fcc89/ovctrl/pcb/Pics and plots/IMG_5339.jpg

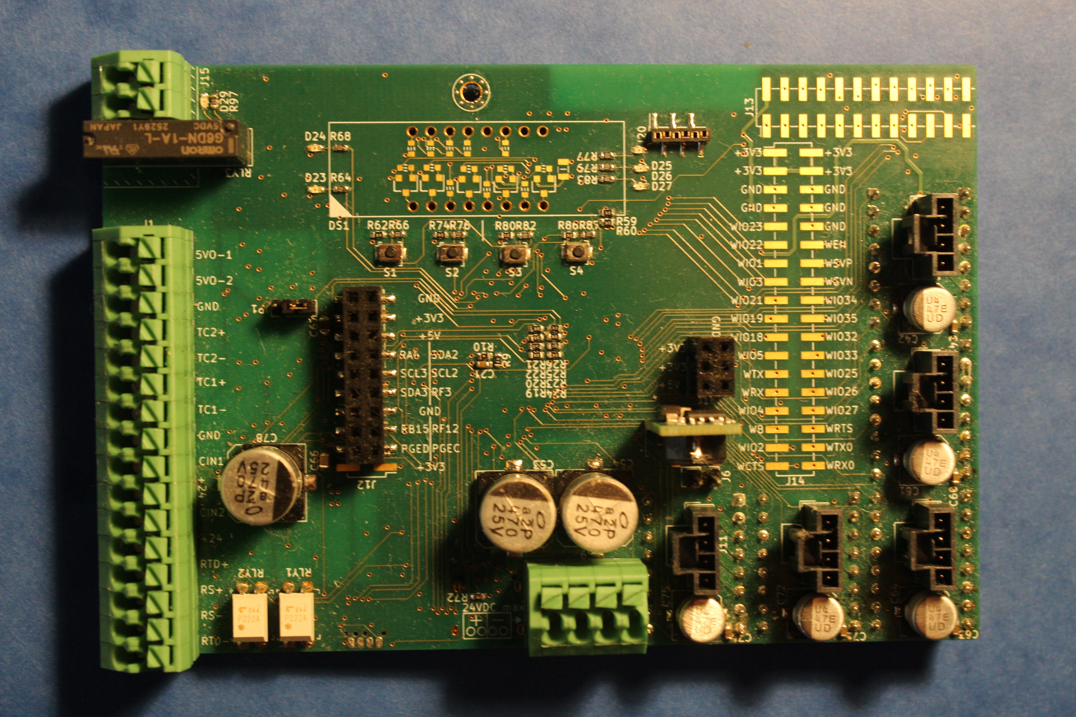
pcb/Pics and plots/IMG_5339.jpg
