fcc89/ovctrl/pcb/Pics and plots/B-bottomView.png

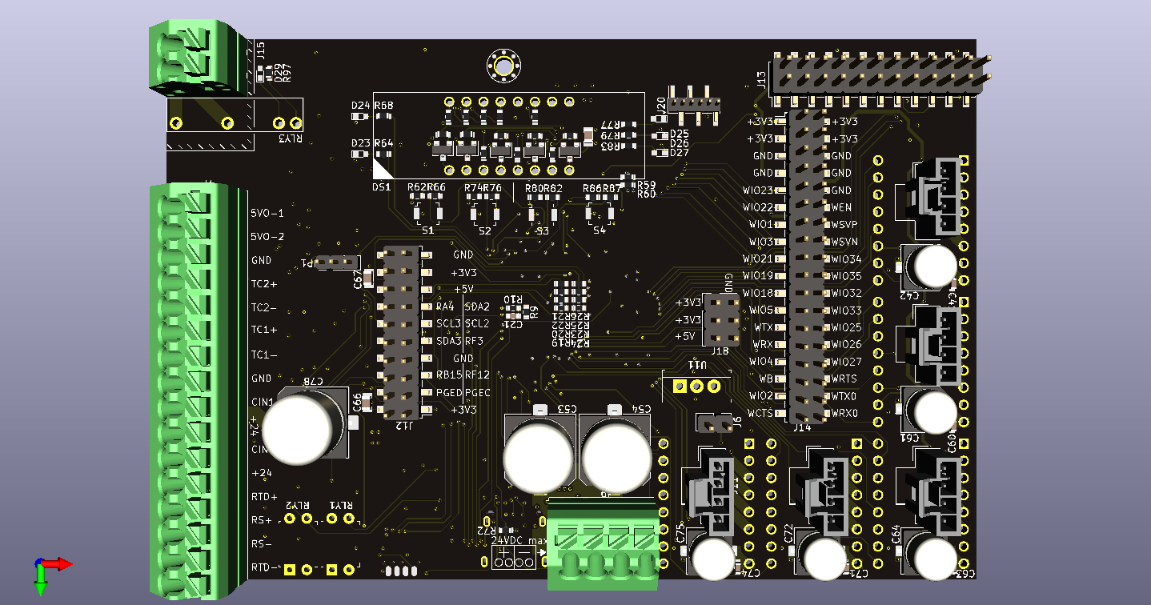
pcb/Pics and plots/B-bottomView.png
