fcc89/ovctrl/README.md

# ROVEN
Testboard for a reflow oven controller
