fcc89/ovctrl/pcb/Pics and plots/C-topView.png

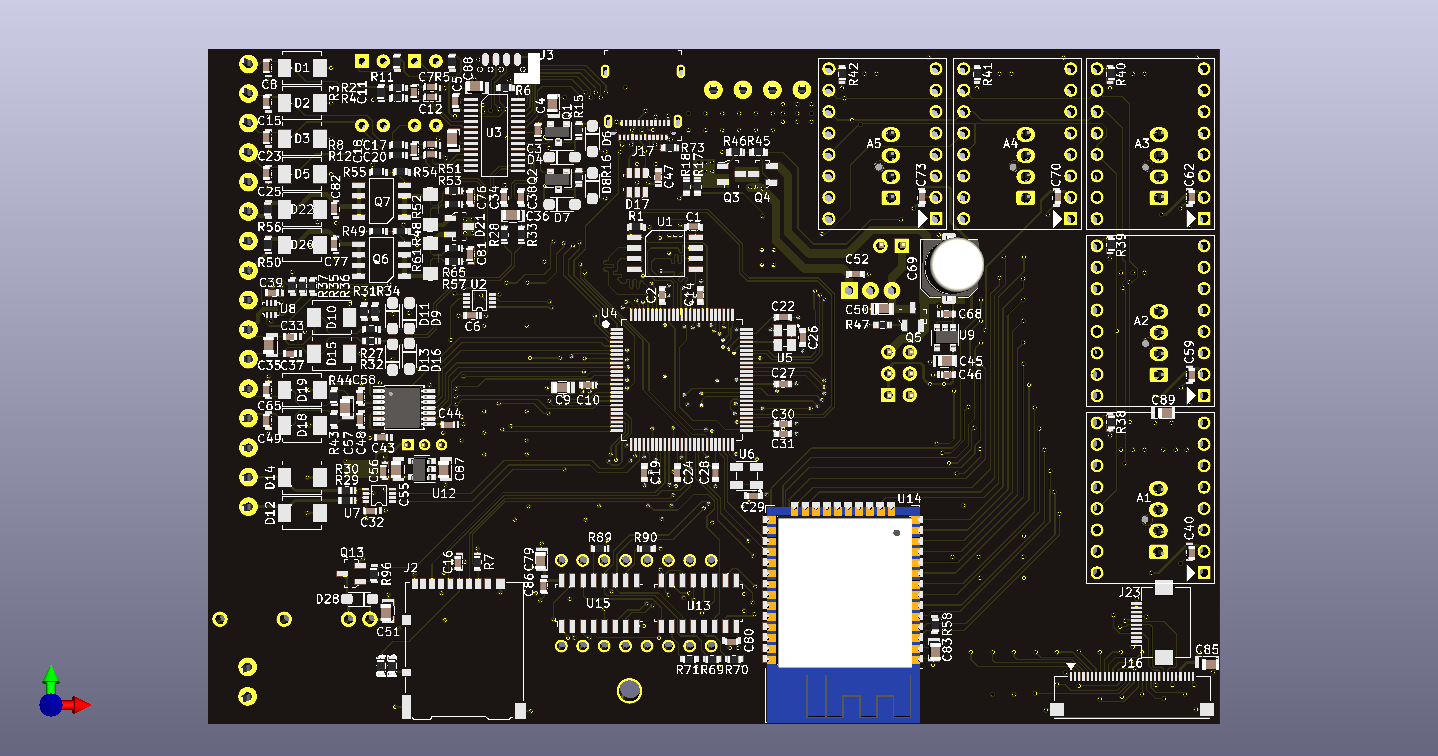
pcb/Pics and plots/C-topView.png
