fcc89/ovctrl/pcb/Pics and plots/IMG_5340.jpg

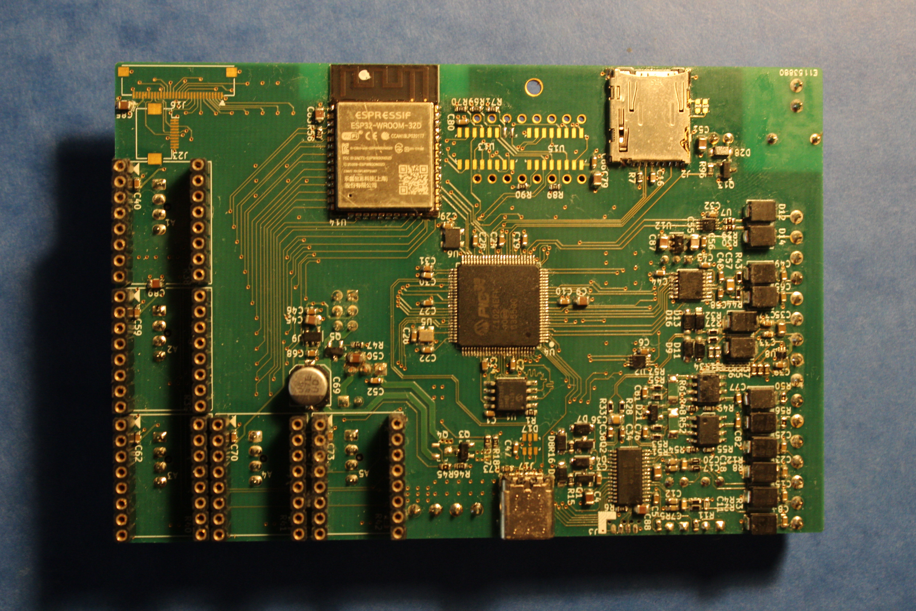
pcb/Pics and plots/IMG_5340.jpg
