fcc89/ovctrl/pcb/Pics and plots/A-Schematic.pdf

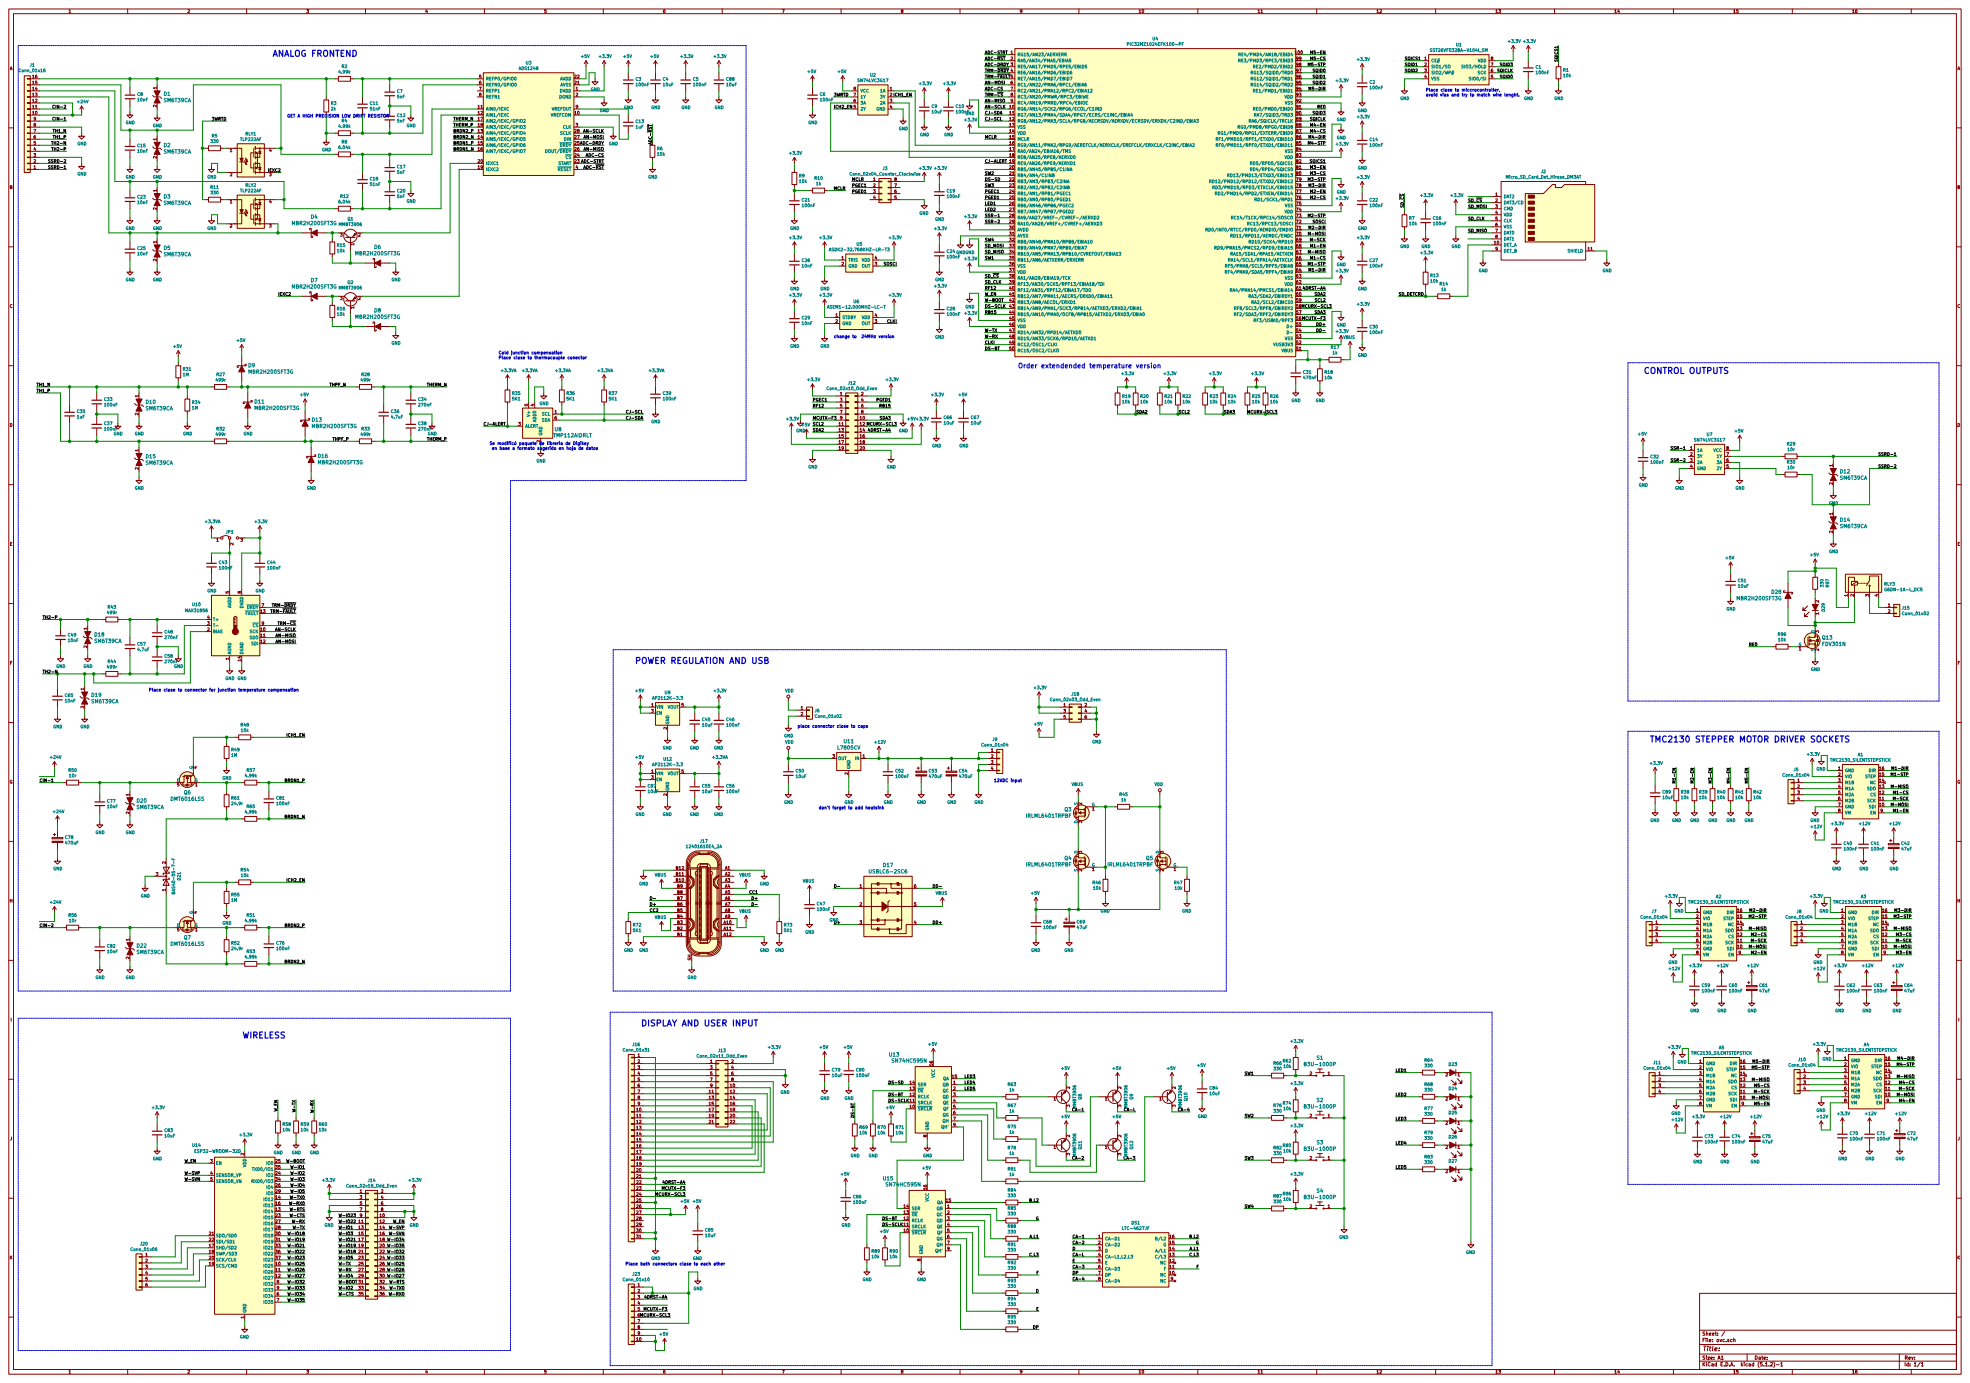
[picture p5: page 1]

ADC-STRT ADC-RST ADC-DRDY

SQICS1 Place close to miccrocontroller, avoid vias and try to match wire lenght.

TRM-DRDY
TRM-FAULT
AN-MOSI AN-MISO
ADC-CS
TRM-CS

AN-SCLK
CJ-SCL CJ-SDA

ADC-DRDY

ADC-STRT ADC-RST GND

Cold junction compensation
Place close to thermocouple conector GND

CJ-SCL CJ-SDA CJ-ALERT

Se modificó paquete de libreria de Digikey
en base a formato sugerido en hoja de datos

1 SCK 10 SDO 11 SDI 12 FAULT 13 DGND 14 BIAS 2 T- 3 T+ 4 AVDD

POWER REGULATION AND USB

Place close to connector for junction temperature compensation
10k GND

place connector close to caps

TMC2130 STEPPER MOTOR DRIVER SOCKETS

don't forget to add heatsink

BRDN2_N
+3.3V W-TX0 W-RX0 W-RTS W-CTS W-BOOT W-RX W-TX

DISPLAY AND USER INPUT
J16 Conn_01x31 GND

10uF GND
DS-SCLK DS-BT DS-BT DS-SCLK
10k GNDDS-BT

2 SCK/CLK 20 SDO/SD0 21 SDI/SD1 22

Place both connectors close to each other

Id: 1/1 Title: File: ovc.sch Sheet: /
