fcc89/ovctrl/pcb/Pics and plots/ovc-B_SilkS.pdf

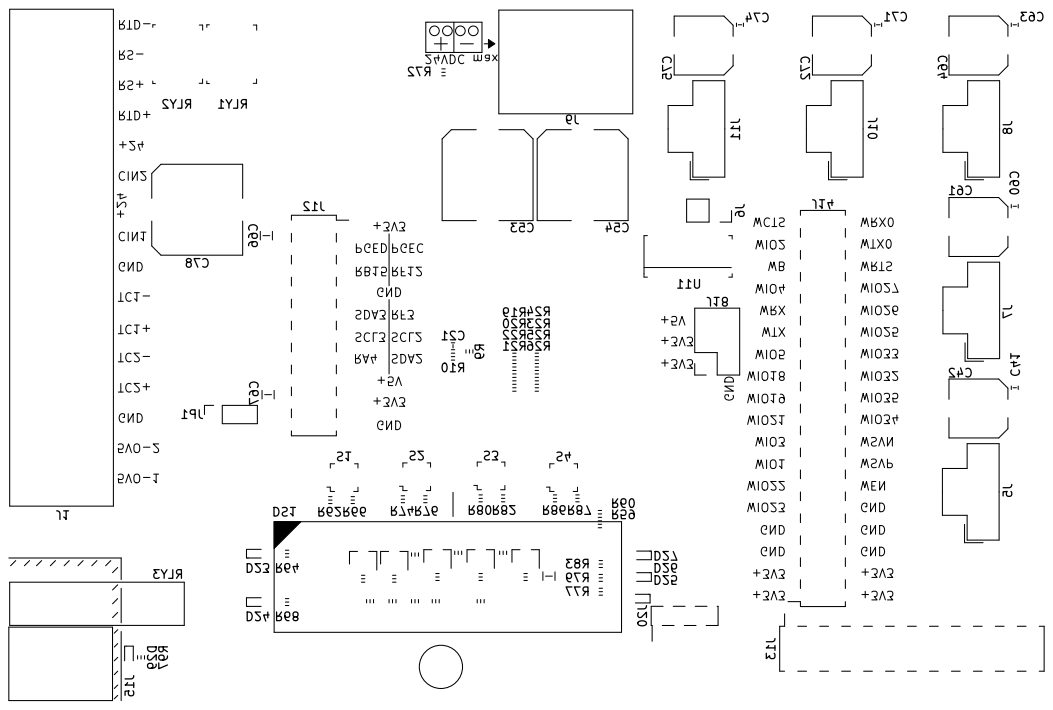
[picture p6: page 1]

WRX0 WTX0 WRTS WIO27 WIO26 WIO25 WIO33 WIO32 WIO35 WIO34 WSVN WSVP WEN GND GND GND
