fcc89/ovctrl/pcb/schematic.pdf

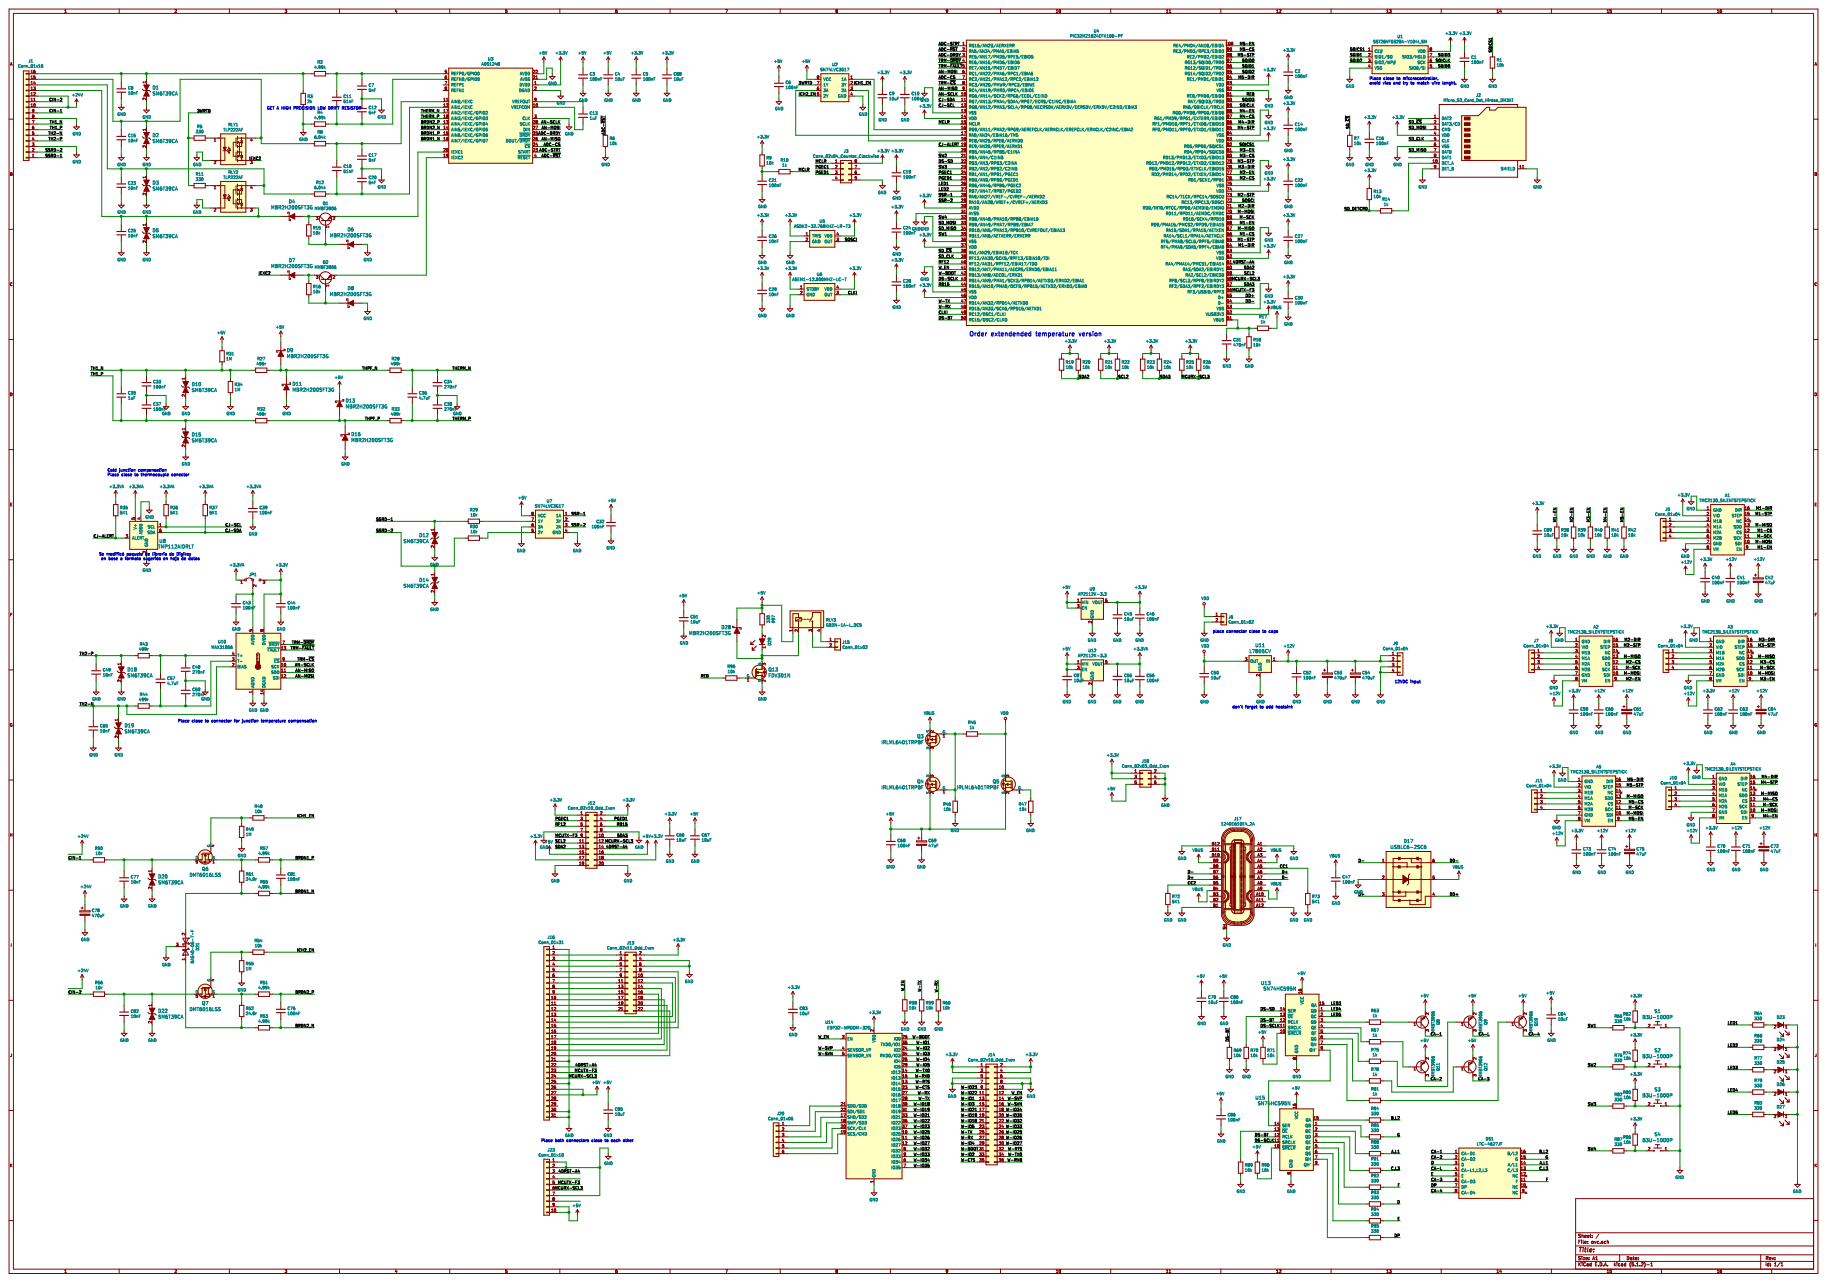
[picture p7: page 1]
