fcc89/ovctrl/pcb/bfab.pdf

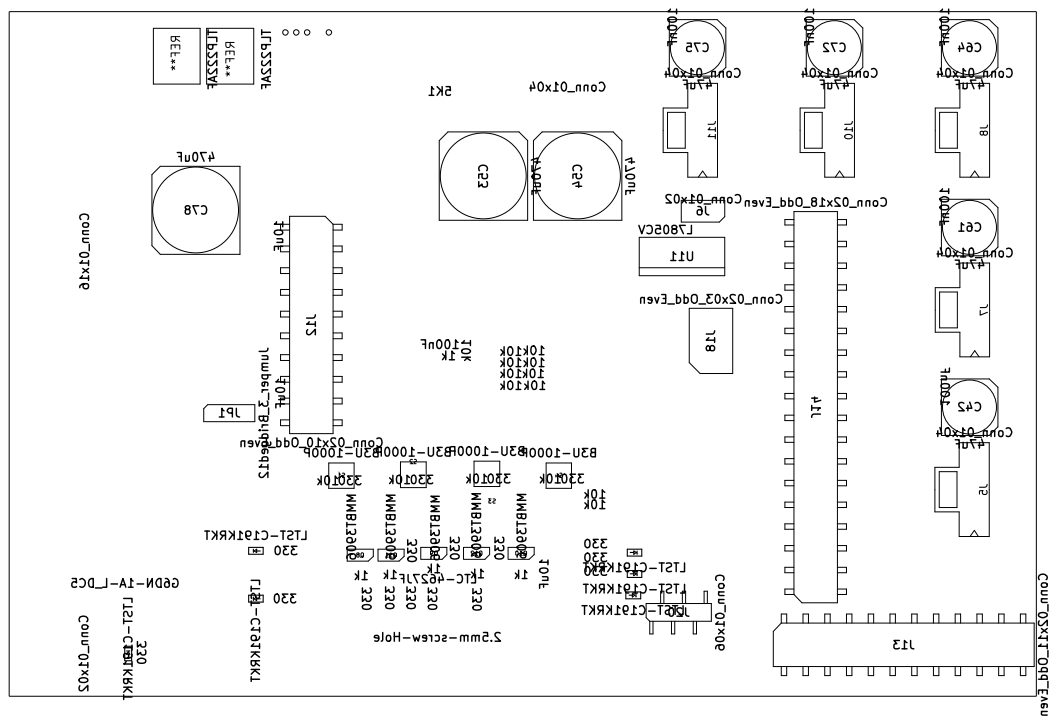
[picture p8: page 1]
