fcc89/ovctrl/pcb/ffab.pdf

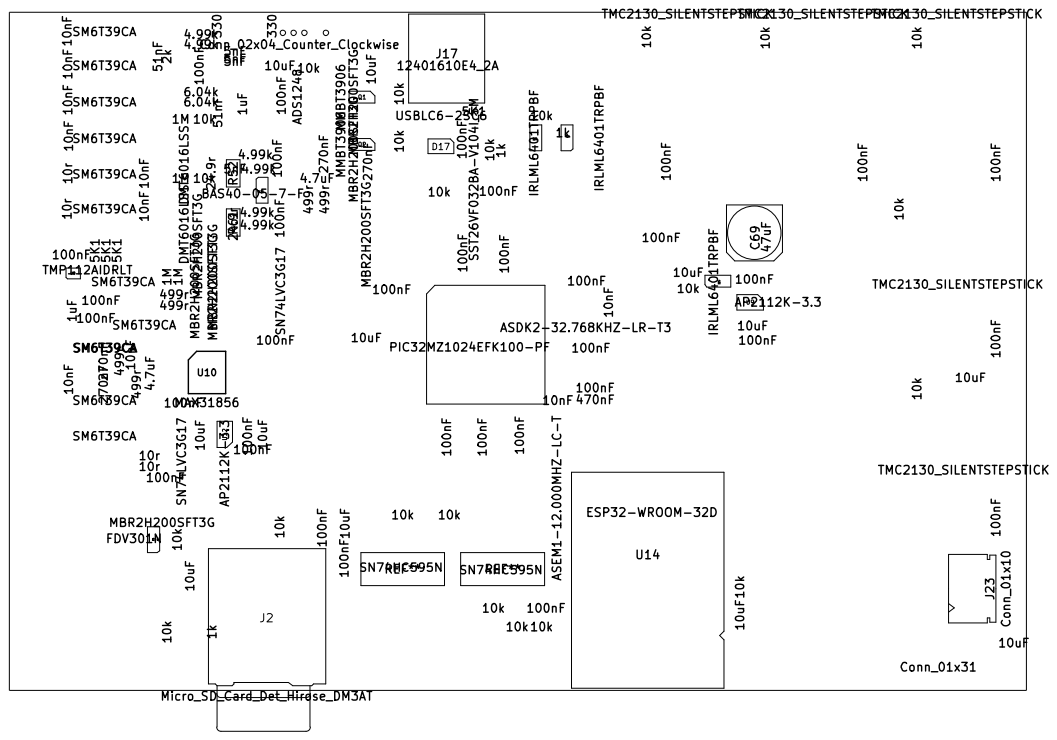
[picture p9: page 1]
