fcc89/ovctrl/pcb/Pics and plots/ovc-B_Cu.pdf

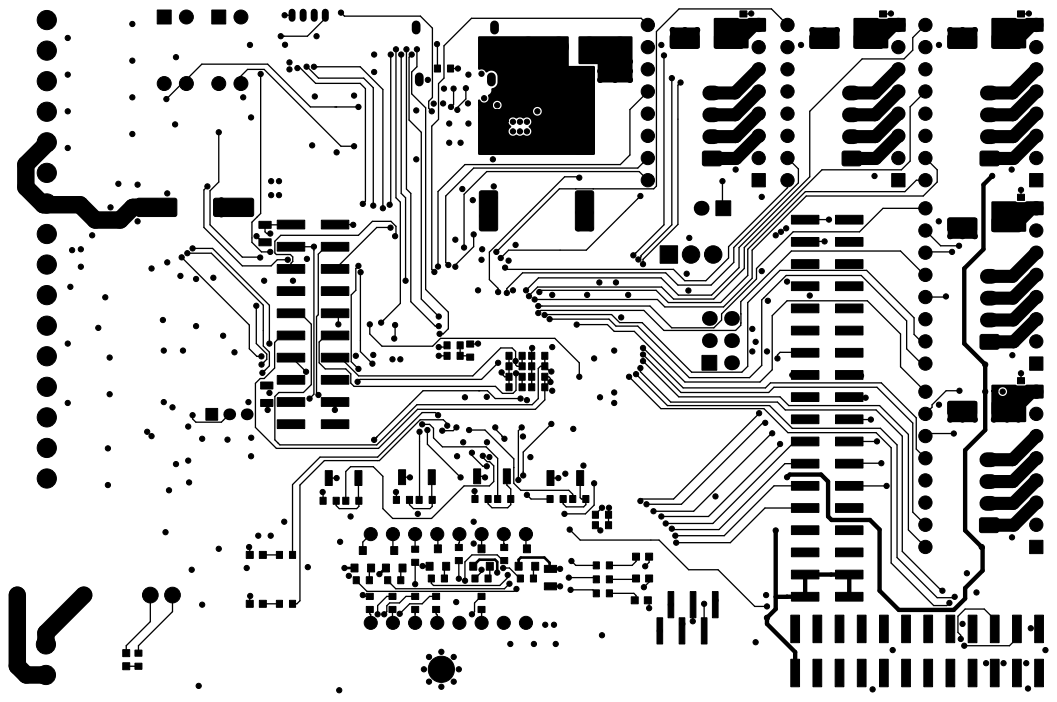
[picture p10: page 1]
