fcc89/ovctrl/pcb/Pics and plots/ovc-B_Mask.pdf

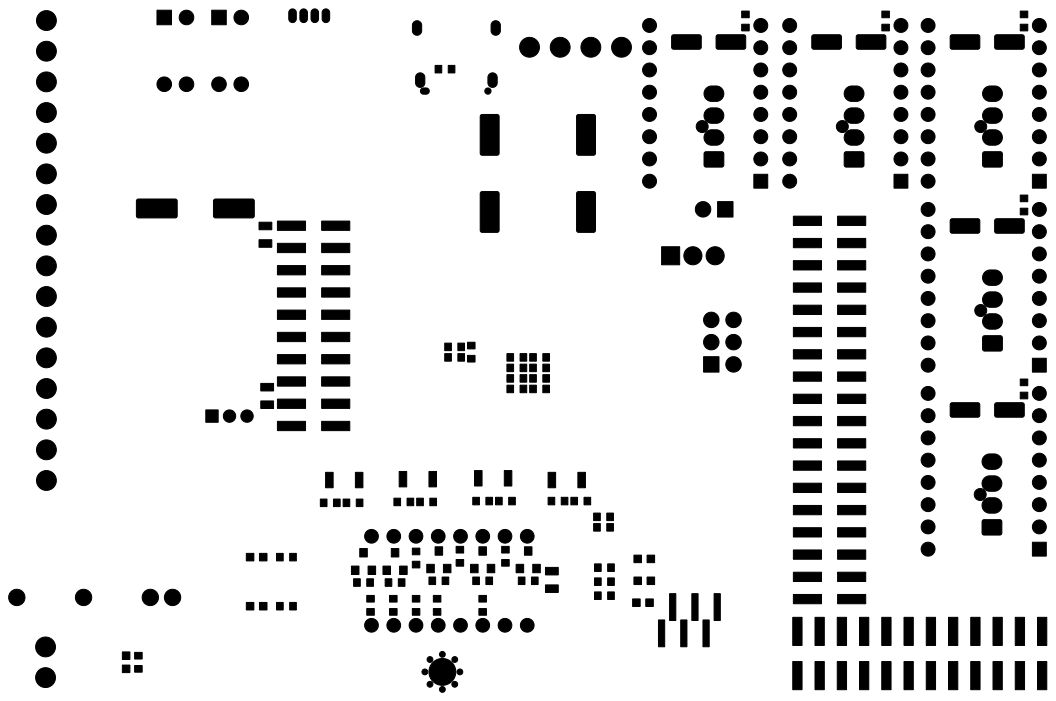
[picture p11: page 1]
