fcc89/ovctrl/pcb/Pics and plots/ovc-Edge_Cuts.pdf

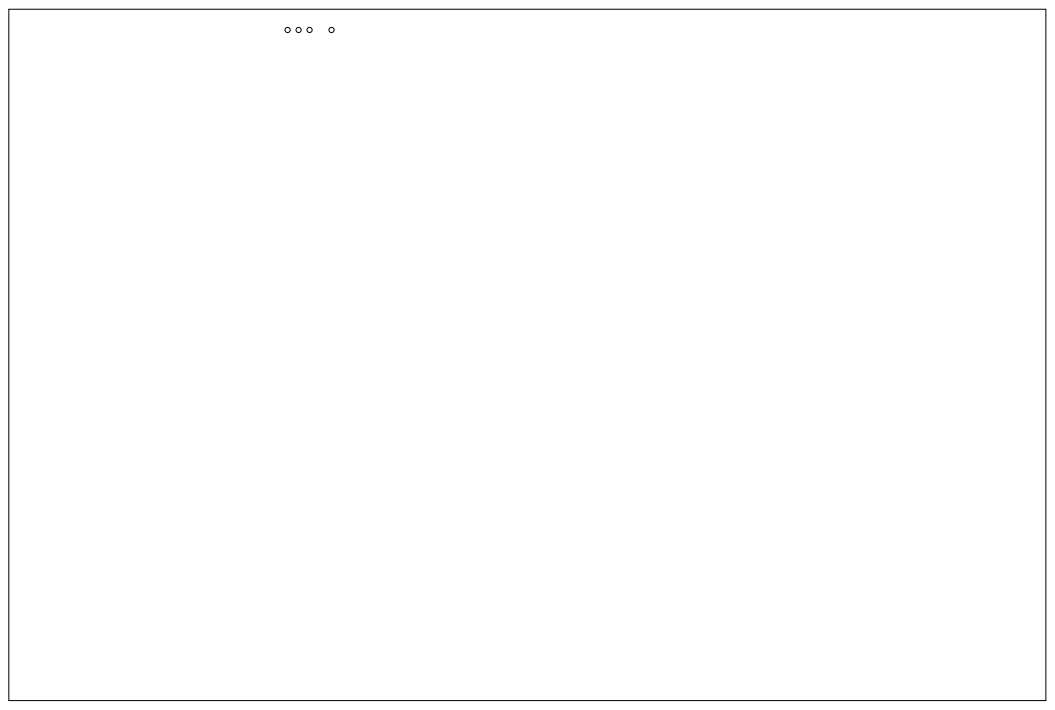
[picture p12: page 1]
