fcc89/ovctrl/pcb/Pics and plots/ovc-F_Cu.pdf

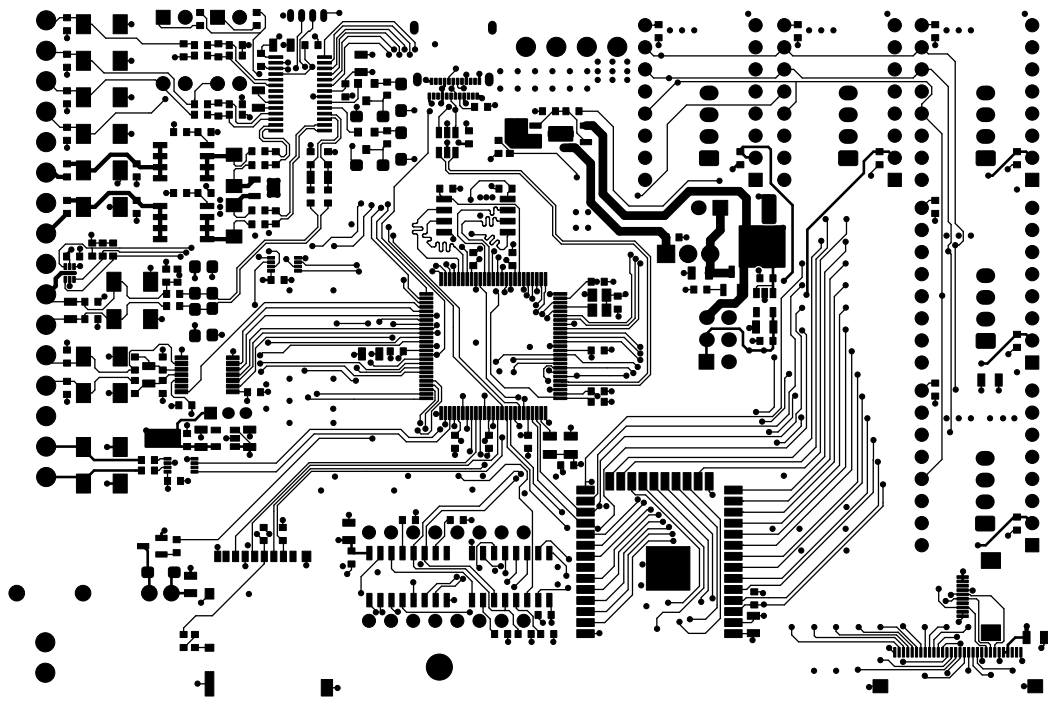
[picture p13: page 1]
