fcc89/ovctrl/pcb/Pics and plots/ovc-F_Mask.pdf

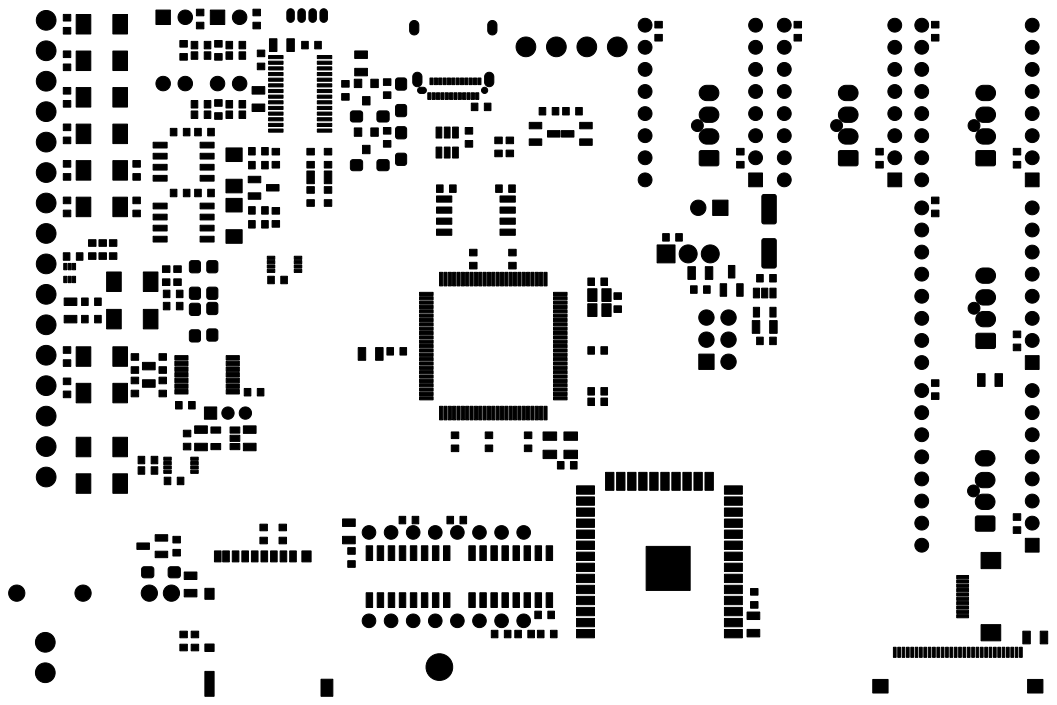
[picture p14: page 1]
