fcc89/ovctrl/pcb/Pics and plots/ovc-F_SilkS.pdf

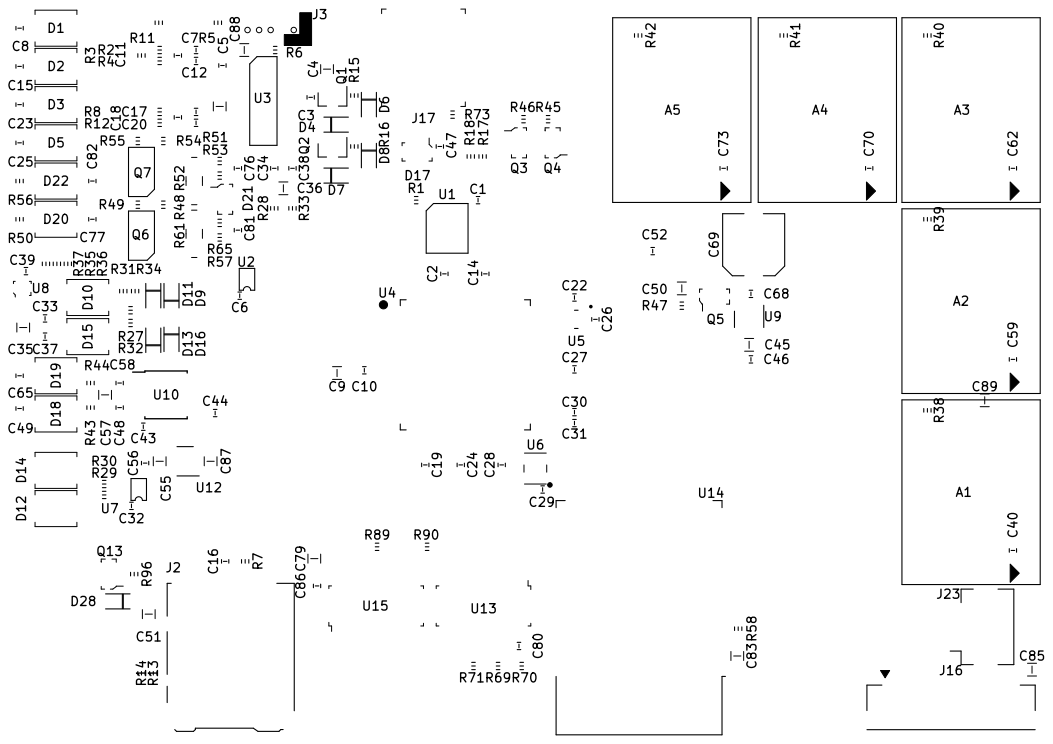
[picture p15: page 1]
