fcc89/ovctrl/pcb/Pics and plots/ovc-In1_Cu.pdf

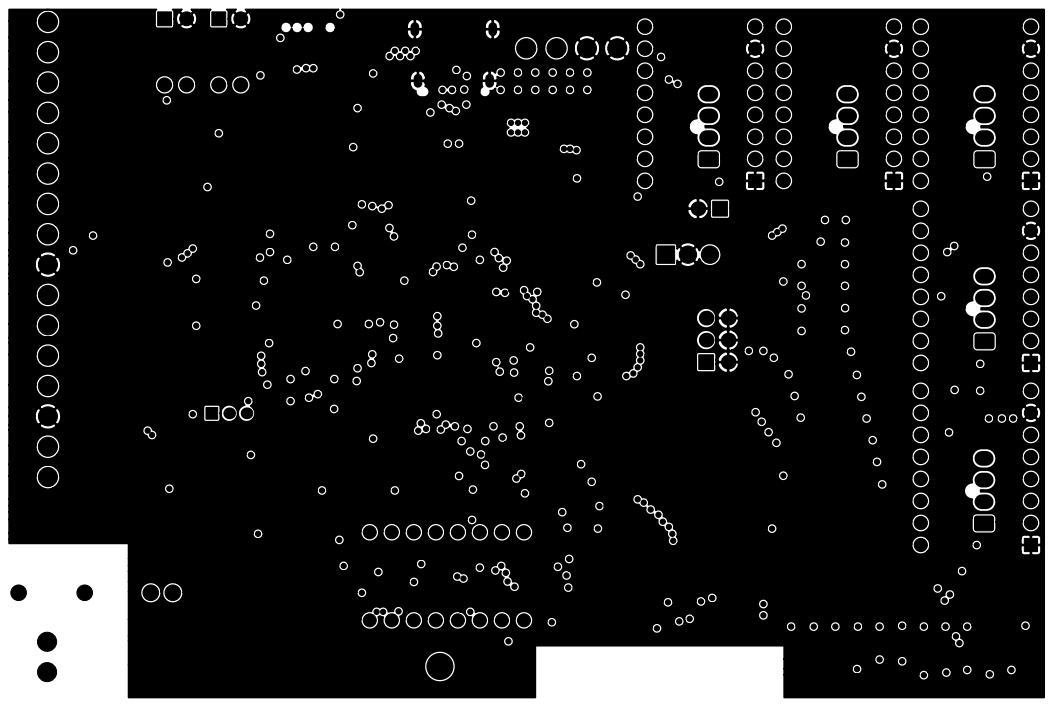
[picture p16: page 1]
