fcc89/ovctrl/pcb/Pics and plots/ovc-In2_Cu.pdf

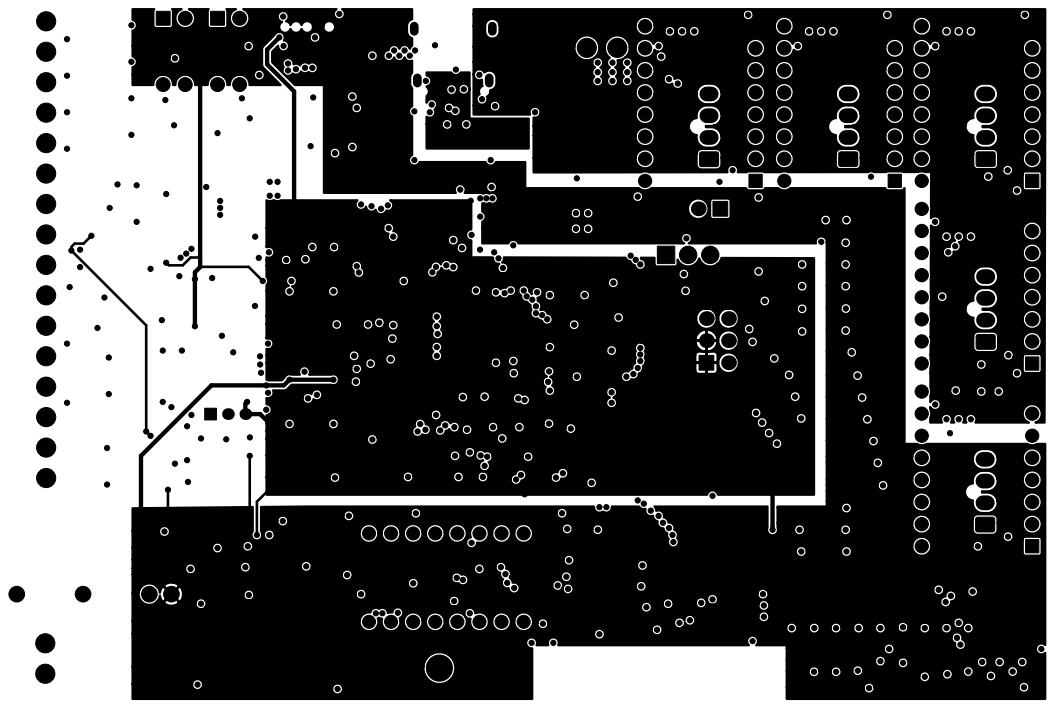
[picture p17: page 1]
