fcc89/ovctrl/pcb/ovc.kicad_pcb

## KiCad design pcb/ovc.kicad_pcb (2019-11-24)

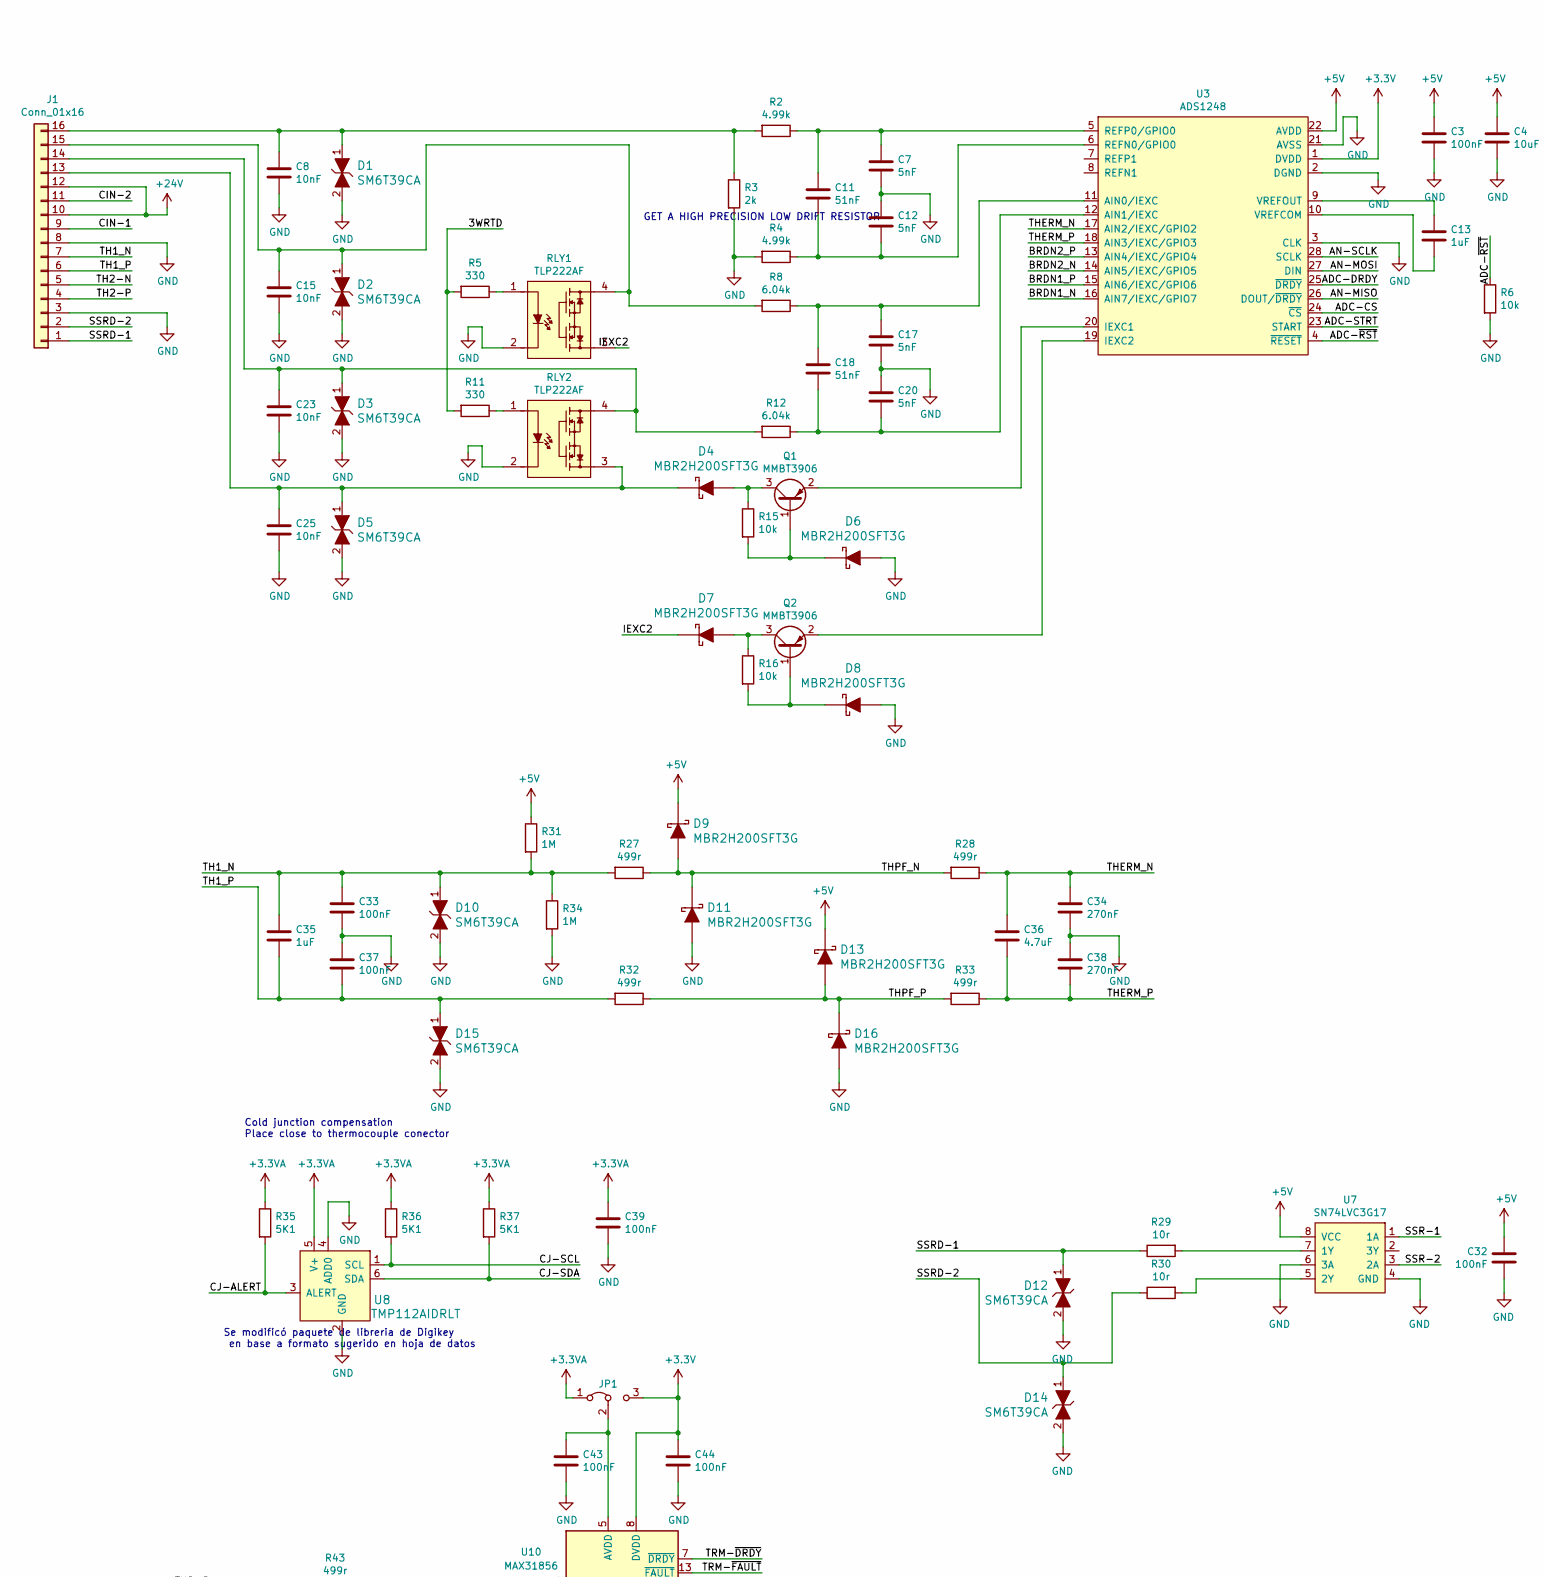
[picture p18: schematic ovc.sch, part in row 1, column 1]

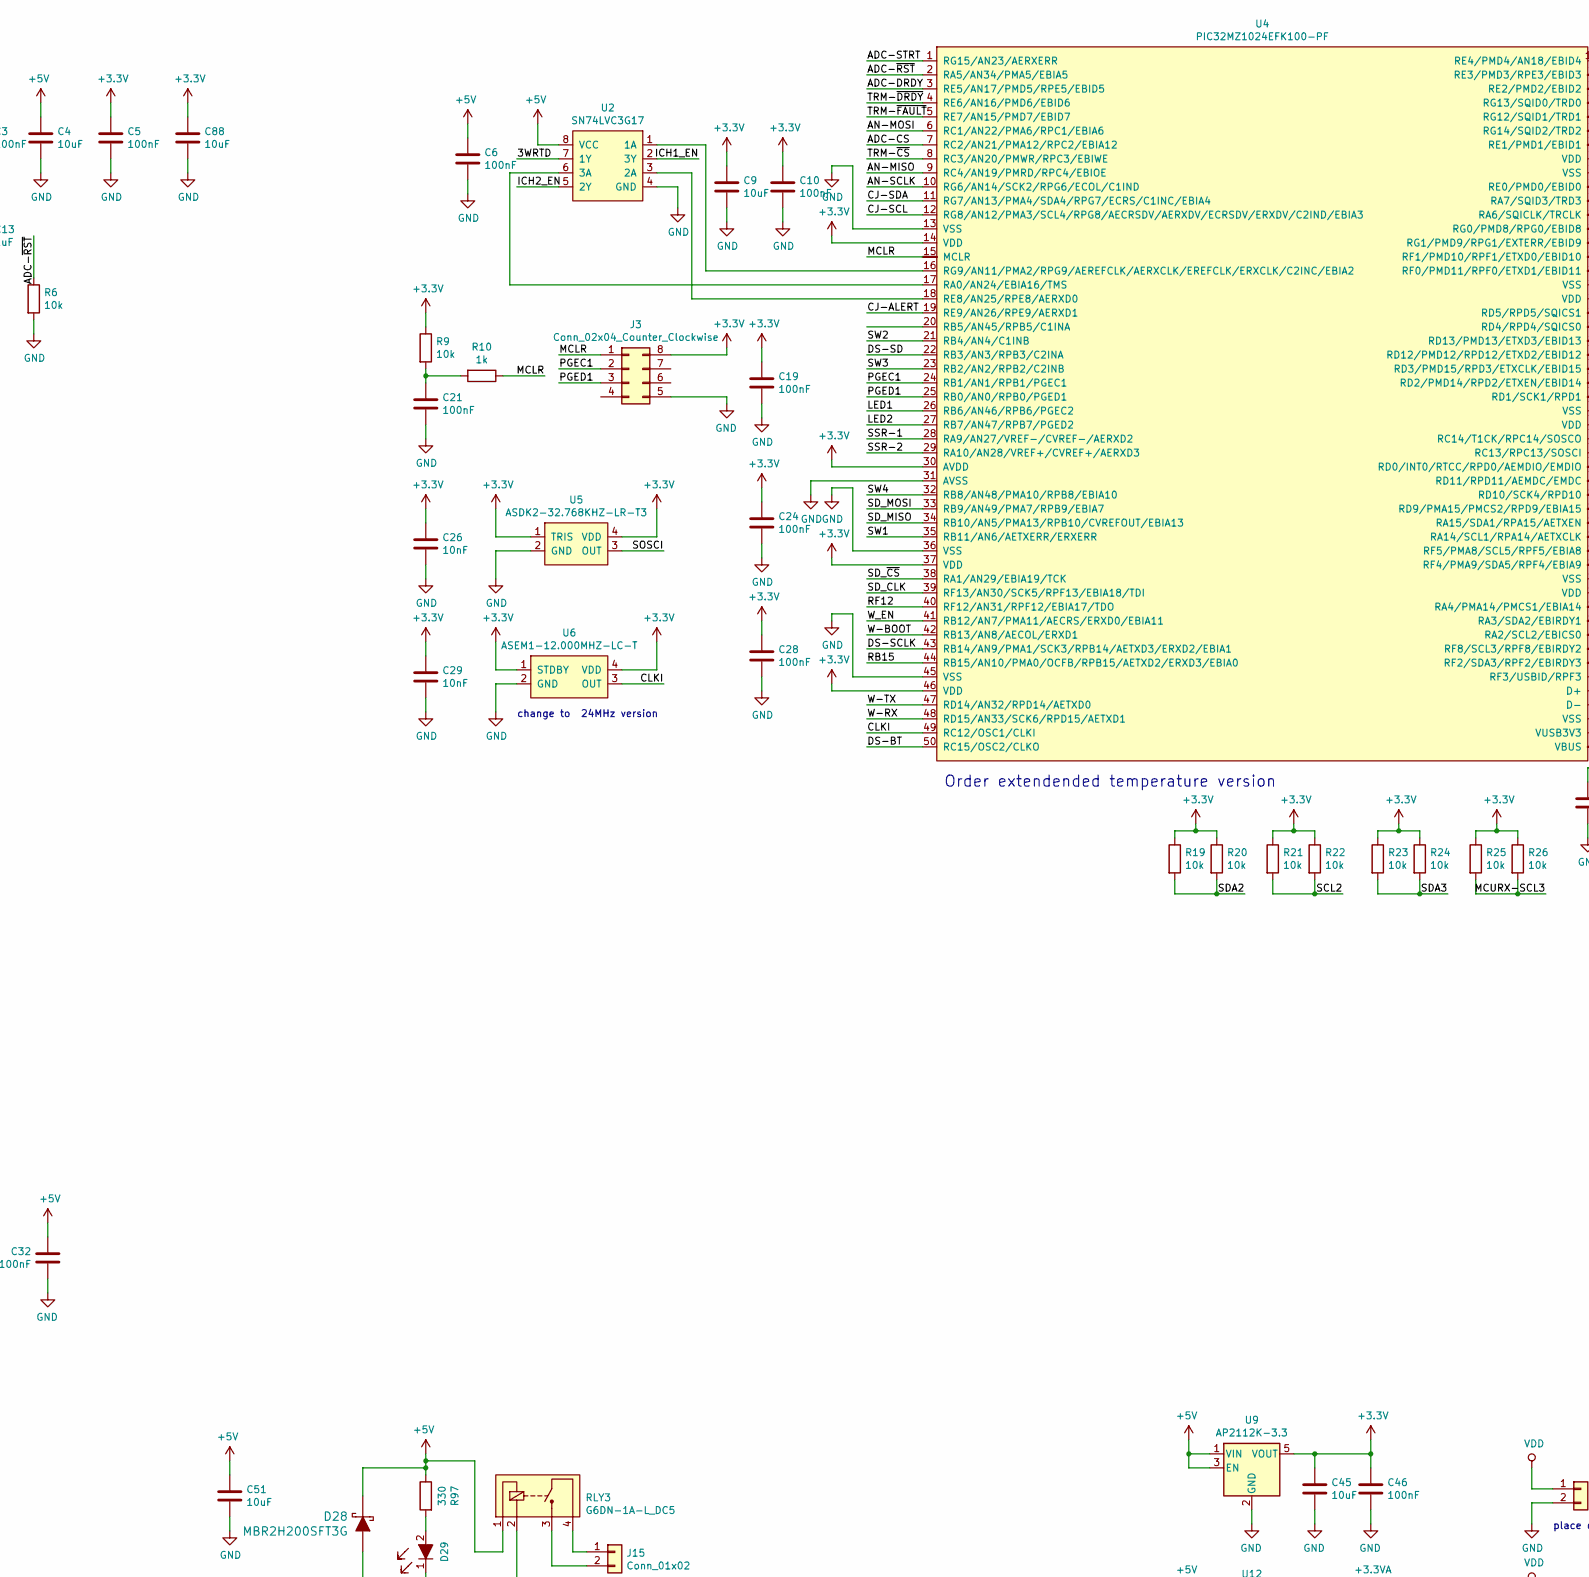
[picture p19: schematic ovc.sch, part in row 1, column 2]

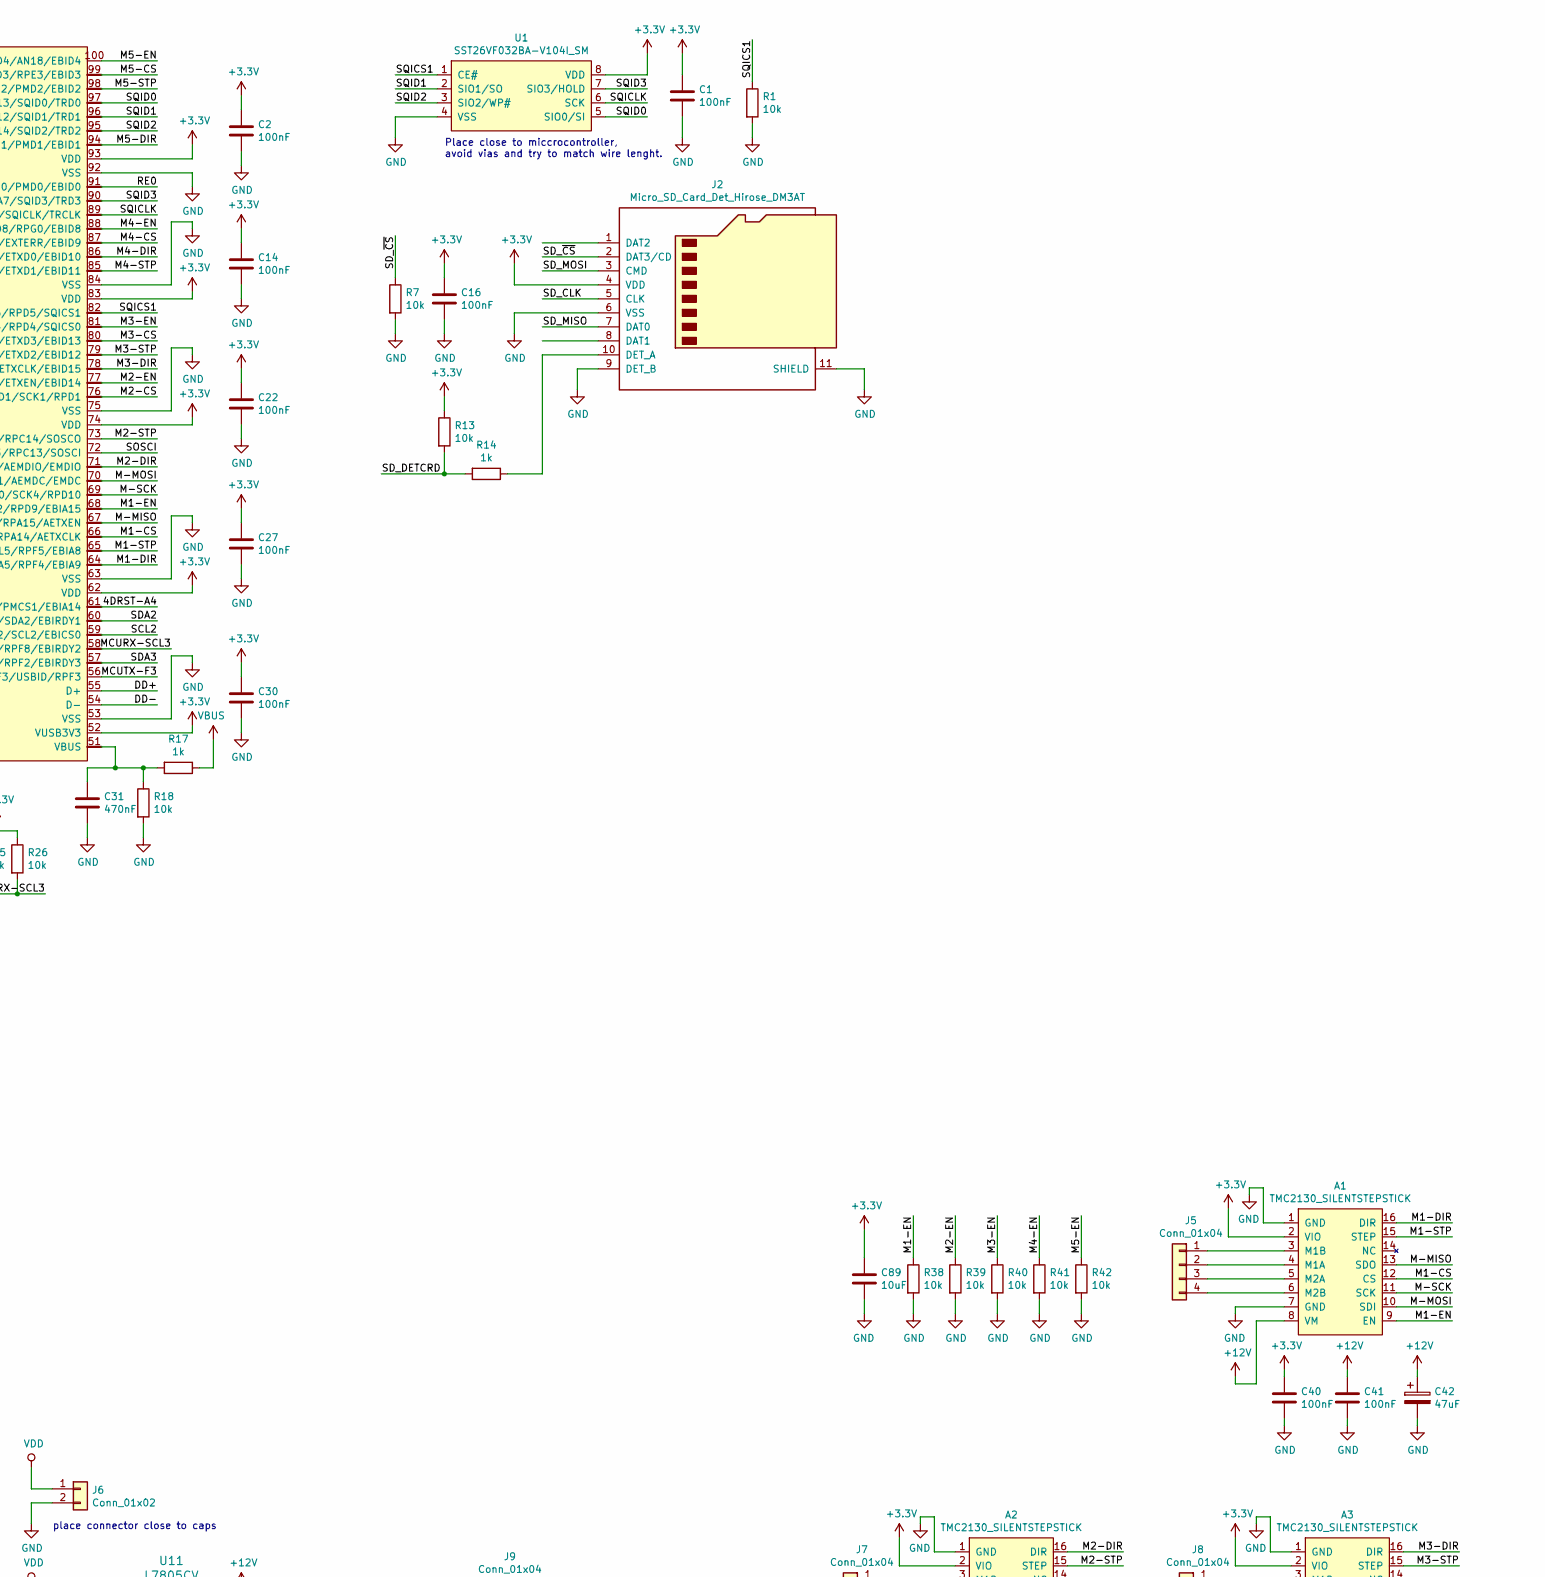
[picture p20: schematic ovc.sch, part in row 1, column 3]

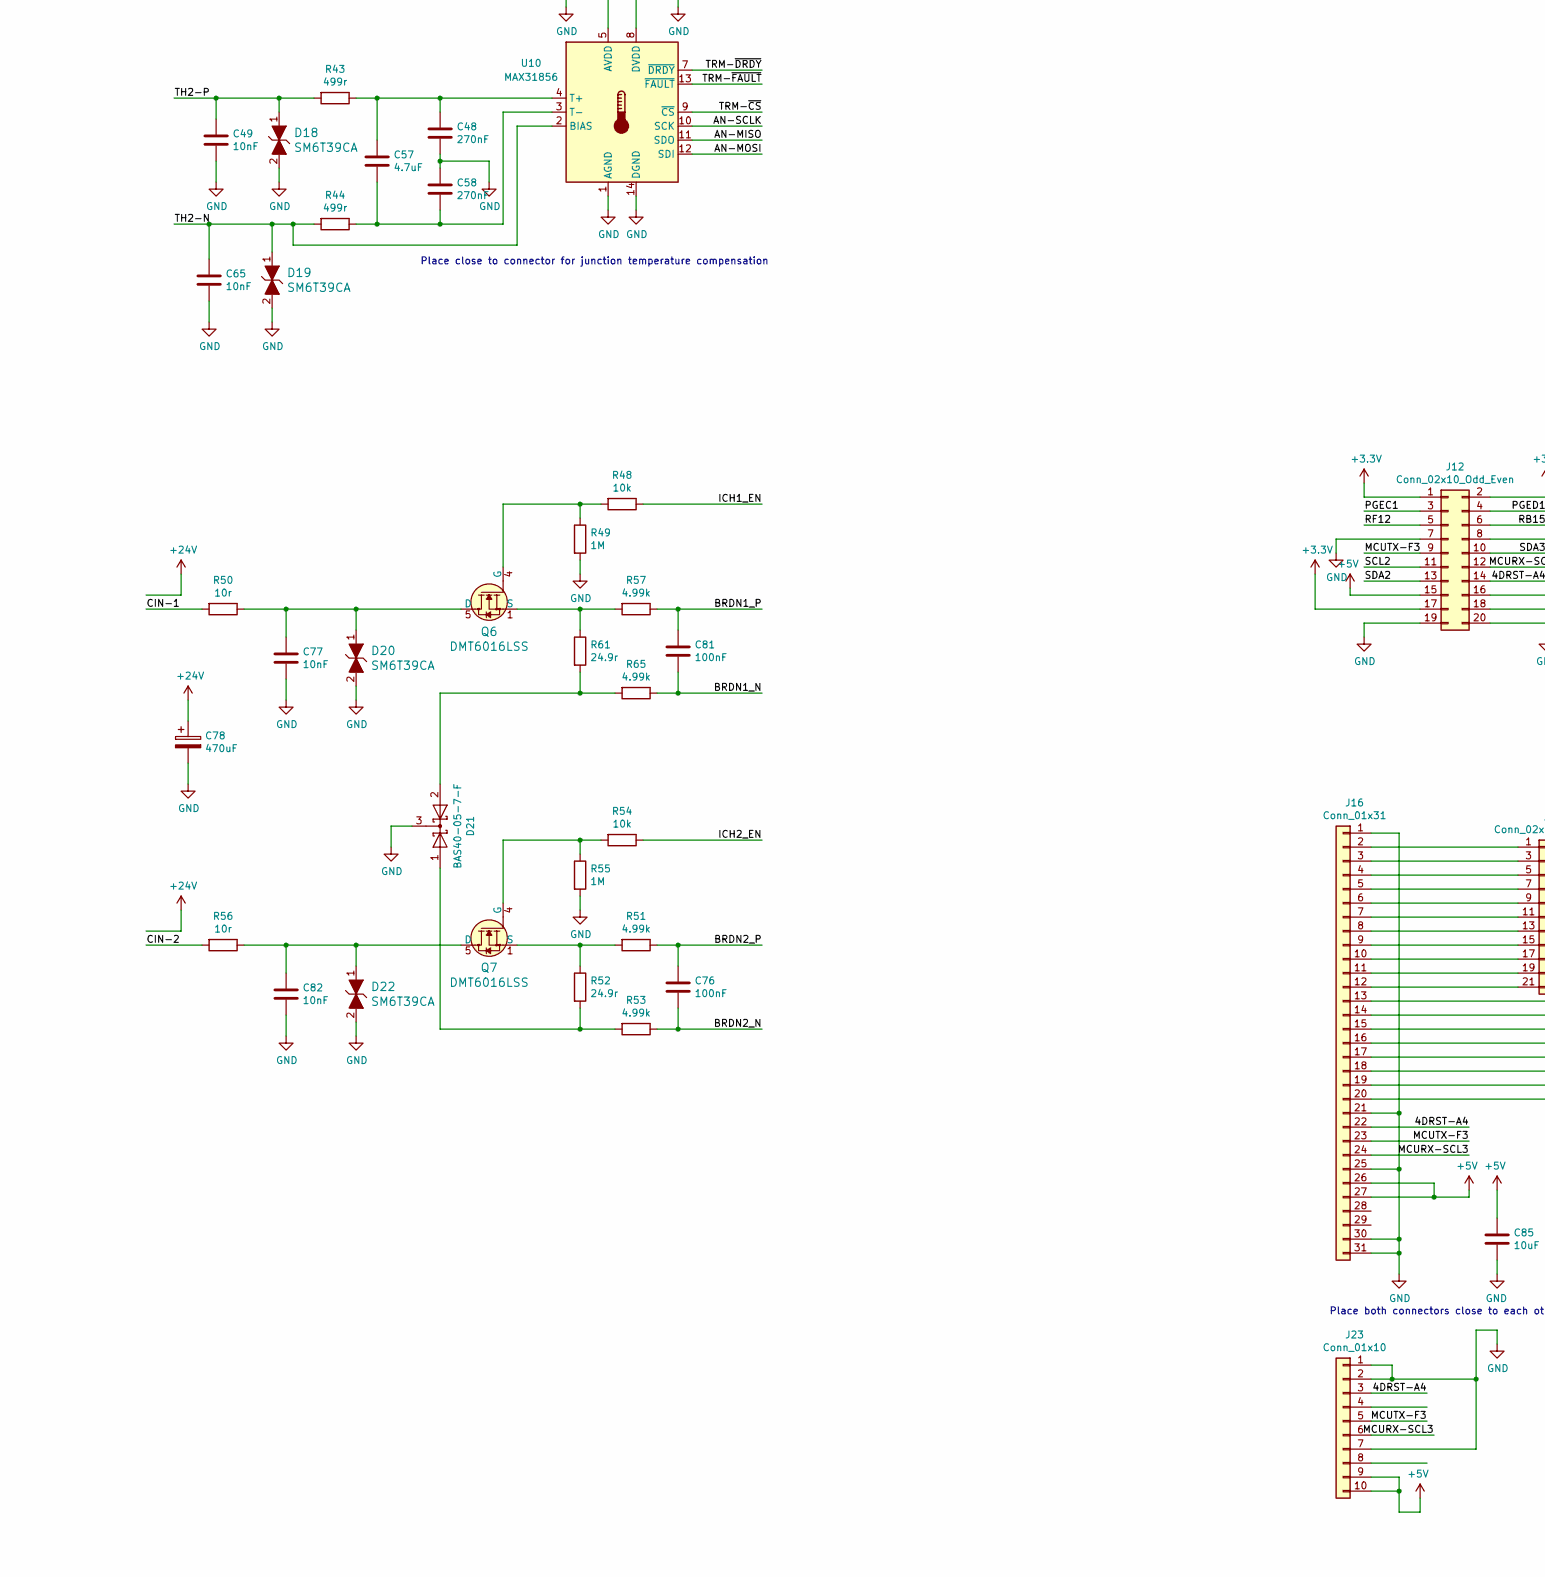
[picture p21: schematic ovc.sch, part in row 2, column 1]

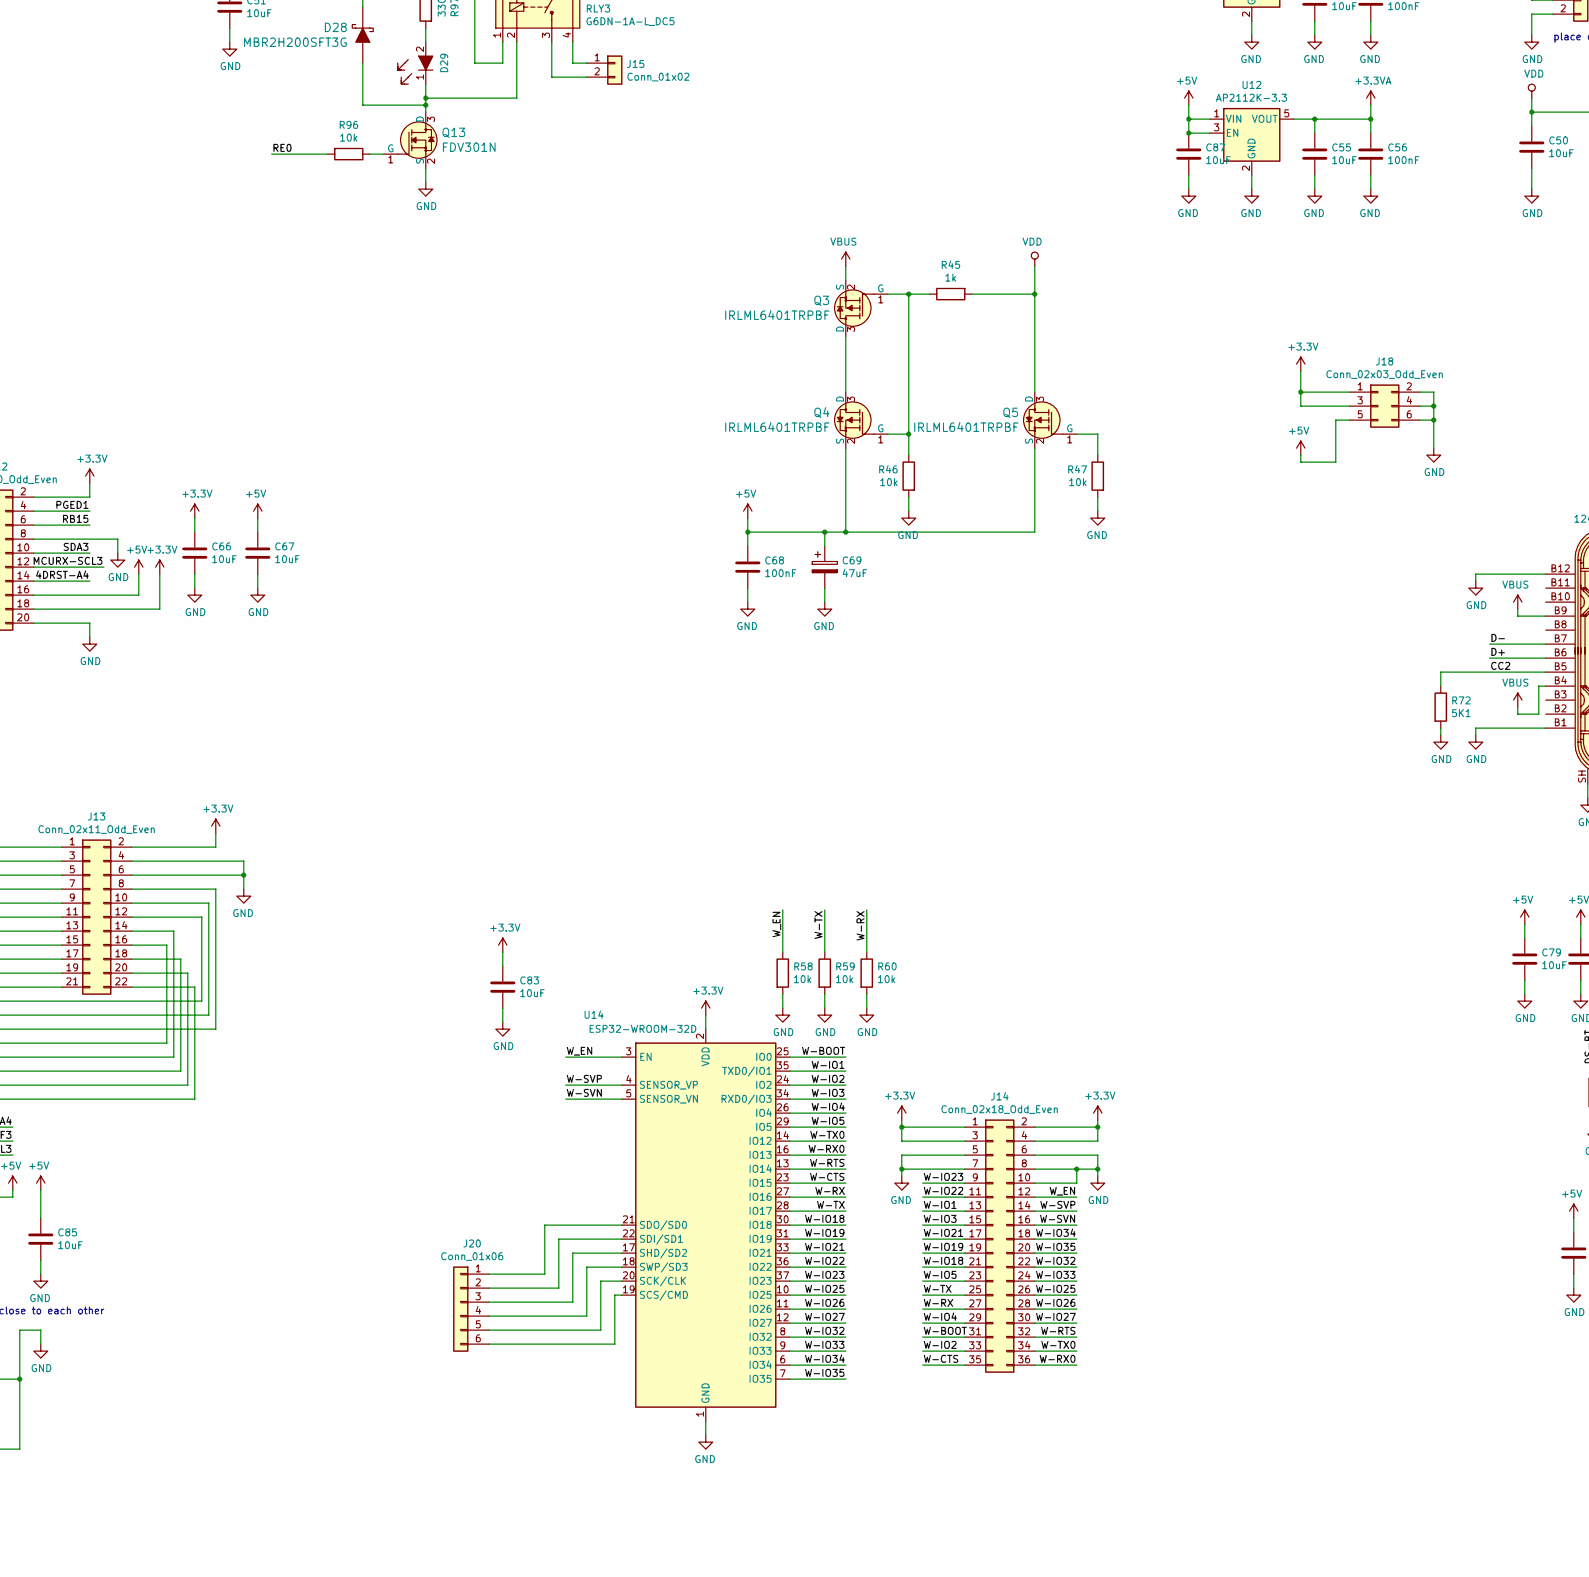
[picture p22: schematic ovc.sch, part in row 2, column 2]

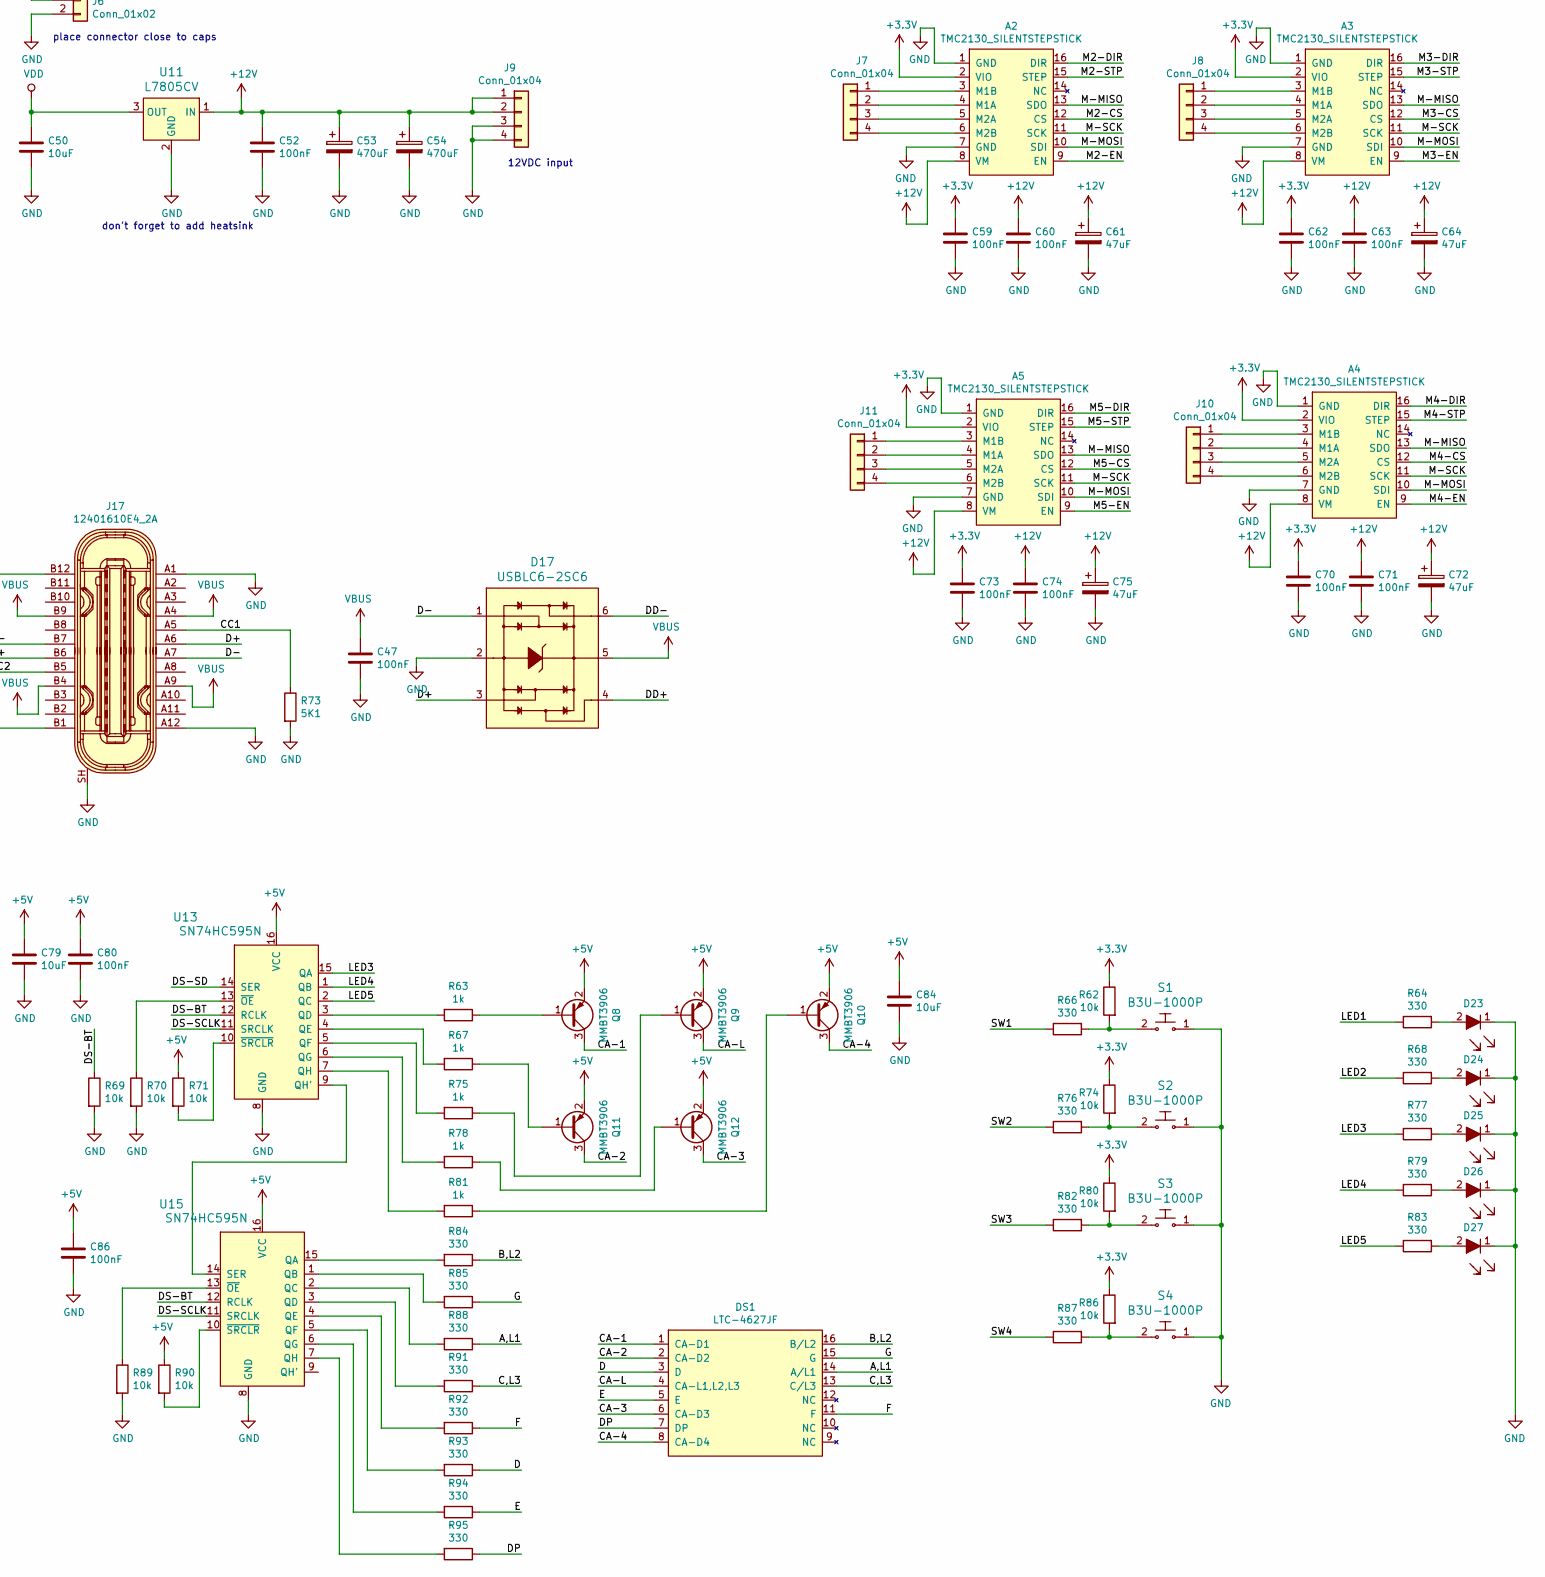
[picture p23: schematic ovc.sch, part in row 2, column 3]

Parts:
A1, A2, A3, A4, A5: TMC2130_SILENTSTEPSTICK; trinamic SILENTSTEPSTICK
C1, C2, C3, C5, C6, C10, C14, C16, C19, C21, C22, C24, C27, C28, C30, C32, C33, C37, C39, C40, C41, C43, C44, C46, C47, C52, C56, C59, C60, C62, C63, C68, C70, C71, C73, C74, C76, C80, C81, C86: 100nF; murata-CAP-GCM-0603-1608metric-reflow
C4, C9, C45, C50, C51, C55, C66, C67, C79, C83, C84, C85, C87, C88, C89: 10uF; murata-CAP-GRM-0805-2012metric-reflow
C7, C12, C17, C20: 5nF; murata-CAP-GCM-0603-1608metric-reflow
C8, C15, C23, C25, C26, C29, C49, C65, C77, C82: 10nF; murata-CAP-GCM-0603-1608metric-reflow
C11, C18: 51nF; murata-CAP-GCM-0603-1608metric-reflow
C13, C35: 1uF; murata-CAP-GRM-0805-2012metric-reflow
C31: 470nF; murata-CAP-GCM-0603-1608metric-reflow
C34, C38, C48, C58: 270nF; murata-CAP-GCM-0603-1608metric-reflow
C36, C57: 4.7uF; murata-CAP-GRM-0805-2012metric-reflow
C42, C61, C64, C69, C72, C75: 47uF; C_Elec_6.3x5.8
C53, C54, C78: 470uF; C_Elec_10x10.2
D1, D2, D3, D5, D10, D12, D14, D15, D18, D19, D20, D22: SM6T39CA; ST-DO214AA; MPN SM6T39CA; Digi-Key_PN 497-6498-1-ND
D4, D6, D7, D8, D9, D11, D13, D16, D28: MBR2H200SFT3G; onsemi-sod123fl; MPN MBR2H200SFT3G; Digi-Key_PN MBR2H200SFT3GOSCT-ND
D17: USBLC6-2SC6; SOT23-6L; MPN USBLC6-2SC6; Digi-Key_PN 497-5235-1-ND
D21: BAS40-05-7-F; SOT-23-3
D23, D24, D25, D26, D27, D29: LTST-C191KRKT; LED_0603; MPN LTST-C191KRKT; Digi-Key_PN 160-1447-1-ND
DS1: LTC-4627JF; liteon-C4627JF
J1: Conn_01x16; phoenix_contact-therminal_block-16pos_PTSA1.5_16-3.5-F-1985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
J2: Micro_SD_Card_Det_Hirose_DM3AT; microSD_HC_Hirose_DM3AT-SF-PEJM5
J3: Conn_02x04_Counter_Clockwise; VC-SOICbite-vcpinout
J5, J7, J8, J10, J11: Conn_01x04; Molex_Nano-Fit_105309-xx04_1x04_P2.50mm_Vertical
J6: Conn_01x02; PinHeader_1x02_P2.54mm_Vertical
J9: Conn_01x04; phoenix_contact-therminal_block-4pos_PTSA1.5-4-3.5-F-1984989
J12: Conn_02x10_Odd_Even; PinHeader_2x10_P2.54mm_Vertical_SMD
J13: Conn_02x11_Odd_Even; PinHeader_2x12_P2.54mm_Vertical_SMD
J14: Conn_02x18_Odd_Even; PinHeader_2x18_P2.54mm_Vertical_SMD
J15: Conn_01x02; phoenix_contact-therminal_block-2pos_PTSA1.5-2-3.5-F-1984963
J16: Conn_01x31; Omron-XF2M-3015-1A
J17: 12401610E4_2A; USB-C_Female_12401X; MPN 12401610E4#2A; Digi-Key_PN 12401610E4#2ACT-ND
J18: Conn_02x03_Odd_Even; PinHeader_2x03_P2.54mm_Vertical
J20: Conn_01x06; PinHeader_1x06_P1.27mm_Vertical_SMD_Pin1Right
J23: Conn_01x10; Hirose_FH12-10S-0.5SH_1x10-1MP_P0.50mm_Horizontal
JP1: Jumper_3_Bridged12; PinHeader_1x03_P2.00mm_Vertical
Q1, Q2, Q8, Q9, Q10, Q11, Q12: MMBT3906; SOT-23
Q3, Q4, Q5: IRLML6401TRPBF; SOT-23-3; MPN IRLML6401TRPBF; Digi-Key_PN IRLML6401PBFCT-ND
Q6, Q7: DMT6016LSS; DIODES-SO8-DMT6016
Q13: FDV301N; SOT-23-3; MPN FDV301N; Digi-Key_PN FDV301NCT-ND
R1, R6, R7, R9, R13, R15, R16, R18, R19, R20, R21, R22, R23, R24, R25, R26, R38, R39, R40, R41, R42, R46, R47, R48, R54, R58, R59, R60, R62, R69, R70, R71, R74, R80, R86, R89, R90, R96: 10k; VC-RES-0603-1608metric
R2, R4, R51, R53, R57, R65: 4.99k; VC-RES-0603-1608metric
R3: 2k; VC-RES-0603-1608metric
R5, R11, R64, R66, R68, R76, R77, R79, R82, R83, R84, R85, R87, R88, R91, R92, R93, R94, R95, R97: 330; VC-RES-0603-1608metric
R8, R12: 6.04k; VC-RES-0603-1608metric
R10, R14, R17, R45, R63, R67, R75, R78, R81: 1k; VC-RES-0603-1608metric
R27, R28, R32, R33, R43, R44: 499r; VC-RES-0603-1608metric
R29, R30, R50, R56: 10r; VC-RES-0603-1608metric
R31, R34, R49, R55: 1M; VC-RES-0603-1608metric
R35, R36, R37, R72, R73: 5K1; VC-RES-0603-1608metric
R52, R61: 24.9r; 1206
RLY1, RLY2: TLP222AF; DIP-4_W7.62mm; MPN TLP222AF; Digi-Key_PN TLP222AF-ND
RLY3: G6DN-1A-L_DC5; Omron G6DN-1A
S1, S2, S3, S4: B3U-1000P; Switch_Tactile_SMD_B3U-1000P; MPN B3U-1000P; Digi-Key_PN SW1020CT-ND
U1: SST26VF032BA-V104I_SM; Microchip-SOIJ-8-1.27mm
U2, U7: SN74LVC3G17; TexasInstruments_DCU8_R-PDSO-G8_0.5mm
U3: ADS1248; texasInstruments-sop-28-PW_R-PDSO-G28
U4: PIC32MZ1024EFK100-PF; Microchip-TQFP-100_14x14_Pitch0.5mm
U5: ASDK2-32.768KHZ-LR-T3; Abracon-ASDK-2.5x2mm_hand-solder
U6: ASEM1-12.000MHZ-LC-T; Abracon-ASEM-3.2x2.5mm_hand-solder
U8: TMP112AIDRLT; SOT-563; MPN TMP112AIDRLT; Digi-Key_PN 296-24621-1-ND
U9, U12: AP2112K-3.3; SOT-23-5
U10: MAX31856; TSSOP-14_4.4x5mm_P0.65mm
U11: L7805CV; TO-220-3; MPN L7805CV; Digi-Key_PN 497-1443-5-ND
U13, U15: SN74HC595N; SOIC-16_W3.90mm; MPN SN74HC595N; Digi-Key_PN 296-1600-5-ND
U14: ESP32-WROOM-32D; ESP32-WROOM-32

Connections:
+3.3VA: C39.1, C55.1, C56.1, JP1.1 (A), R35.1, R36.1, R37.1, U8.5 (V+), U12.5 (VOUT)
+3V3: A1.2 (VIO), A2.2 (VIO), A3.2 (VIO), A4.2 (VIO), A5.2 (VIO), C1.1, C2.1, C5.1, C9.1, C10.1, C14.1, C16.1, C19.1, C22.1, C24.1, C26.1, C27.1, C28.1, C29.1, C30.1, C40.1, C44.1, C45.1, C46.1, C59.1, C62.1, C66.1, C70.1, C73.1, C83.1, C88.1, C89.1, J2.4 (VDD), J3.8, J12.1, J12.2, J12.17, J12.18, J13.2, J14.1, J14.2, J14.3, J14.4, J18.1, J18.3, JP1.3 (B), R9.1, R13.1, R19.1, R20.1, R21.1, R22.1, R23.1, R24.1, R25.1, R26.1, R62.1, R74.1, R80.1, R86.1, U1.8 (VDD), U3.1 (DVDD), U4.14 (VDD), U4.30 (AVDD), U4.37 (VDD), U4.46 (VDD), U4.52 (VUSB3V3), U4.62 (VDD), U4.74 (VDD), U4.83 (VDD), U4.93 (VDD), U5.1 (TRIS), U5.4 (VDD), U6.1 (STDBY), U6.4 (VDD), U9.5 (VOUT), U10.8 (DVDD), U14.2 (VDD)
+5V: C3.1, C4.1, C6.1, C32.1, C51.1, C67.1, C68.1, C69.1, C79.1, C80.1, C84.1, C85.1, C86.1, C87.1, D9.K, D13.K, D28.K, J12.15, J12.16, J16.26, J16.27, J18.5, J23.9, J23.10, Q4.2 (S), Q5.2 (S), Q8.2 (E), Q9.2 (E), Q10.2 (E), Q11.2 (E), Q12.2 (E), R31.1, R71.1, R90.1, R97.1, RLY3.1 (C1), U2.8 (VCC), U3.22 (AVDD), U7.8 (VCC), U9.1 (VIN), U9.3 (EN), U12.1 (VIN), U12.3 (EN), U13.16 (VCC), U15.16 (VCC)
+12V: A1.8 (VM), A2.8 (VM), A3.8 (VM), A4.8 (VM), A5.8 (VM), C41.1, C42.1, C52.1, C53.1, C54.1, C60.1, C61.1, C63.1, C64.1, C71.1, C72.1, C74.1, C75.1, J9.1, J9.2, U11.1 (IN)
+24V: C78.1, J1.10, J1.12
/3WRTD: R5.2, R11.2, U2.7 (1Y)
/4DRST-A4: J12.14, J16.22, J23.3, U4.61 (RA4/PMA14/PMCS1/EBIA14)
/A,L1: DS1.14 (A/L1), R88.1
/ADC-CS: U3.24 (~CS~), U4.7 (RC2/AN21/PMA12/RPC2/EBIA12)
/ADC-DRDY: U3.25 (~DRDY~), U4.3 (RE5/AN17/PMD5/RPE5/EBID5)
/ADC-STRT: U3.23 (START), U4.1 (RG15/AN23/AERXERR)
/ADC-~RST~: R6.1, U3.4 (~RESET~), U4.2 (RA5/AN34/PMA5/EBIA5)
/AN-MISO: U3.26 (DOUT/~DRDY~), U4.9 (RC4/AN19/PMRD/RPC4/EBIOE), U10.11 (SDO)
/AN-MOSI: U3.27 (DIN), U4.6 (RC1/AN22/PMA6/RPC1/EBIA6), U10.12 (SDI)
/AN-SCLK: U3.28 (SCLK), U4.10 (RG6/AN14/SCK2/RPG6/ECOL/C1IND), U10.10 (SCK)
/B,L2: DS1.16 (B/L2), R84.1
/BRDN1_N: C81.2, R65.1, U3.16 (AIN7/IEXC/GPIO7)
/BRDN1_P: C81.1, R57.1, U3.15 (AIN6/IEXC/GPIO6)
/BRDN2_N: C76.2, R53.1, U3.14 (AIN5/IEXC/GPIO5)
/BRDN2_P: C76.1, R51.1, U3.13 (AIN4/IEXC/GPIO4)
/C,L3: DS1.13 (C/L3), R91.1
/CA-1: DS1.1 (CA-D1), Q8.3 (C)
/CA-2: DS1.2 (CA-D2), Q11.3 (C)
/CA-3: DS1.6 (CA-D3), Q12.3 (C)
/CA-4: DS1.8 (CA-D4), Q10.3 (C)
/CA-L: DS1.4 (CA-L1,L2,L3), Q9.3 (C)
/CC1: J17.A5, R73.1
/CC2: J17.B5, R72.1
/CIN-1: J1.9, R50.2
/CIN-2: J1.11, R56.2
/CJ-ALERT: R35.2, U4.19 (RE9/AN26/RPE9/AERXD1), U8.3 (ALERT)
/CJ-SCL: R36.2, U4.12 (RG8/AN12/PMA3/SCL4/RPG8/AECRSDV/AERXDV/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), U8.1 (SCL)
/CJ-SDA: R37.2, U4.11 (RG7/AN13/PMA4/SDA4/RPG7/ECRS/C1INC/EBIA4), U8.6 (SDA)
/CLKI: U4.49 (RC12/OSC1/CLKI), U6.3 (OUT)
/D: DS1.3 (D), R93.1
/D+: D17.3, J17.A6, J17.B6
/D-: D17.1, J17.A7, J17.B7
/DD+: D17.4, U4.55 (D+)
/DD-: D17.6, U4.54 (D-)
/DP: DS1.7 (DP), R95.1
/DS-BT: R69.1, U4.50 (RC15/OSC2/CLKO), U13.12 (RCLK), U15.12 (RCLK)
/DS-SCLK: U4.43 (RB14/AN9/PMA1/SCK3/RPB14/AETXD3/ERXD2/E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), U13.11 (SRCLK), U15.11 (SRCLK)
/DS-SD: U4.22 (RB3/AN3/RPB3/C2INA), U13.14 (SER)
/E: DS1.5 (E), R94.1
/F: DS1.11 (F), R92.1
/G: DS1.15 (G), R85.1
/ICH1_EN: R48.1, U2.2 (3Y)
/ICH2_EN: R54.1, U2.5 (2Y)
/IEXC2: D7.K, RLY1.3 (DRAIN)
/LED1: R64.1, U4.26 (RB6/AN46/RPB6/PGEC2)
/LED2: R68.1, U4.27 (RB7/AN47/RPB7/PGED2)
/LED3: R77.1, U13.15 (QA)
/LED4: R79.1, U13.1 (QB)
/LED5: R83.1, U13.2 (QC)
/M1-CS: A1.12 (CS), U4.66 (RA14/SCL1/RPA14/AETXCLK)
/M1-DIR: A1.16 (DIR), U4.64 (RF4/PMA9/SDA5/RPF4/EBIA9)
/M1-EN: A1.9 (EN), R38.1, U4.68 (RD9/PMA15/PMCS2/RPD9/EBIA15)
/M1-STP: A1.15 (STEP), U4.65 (RF5/PMA8/SCL5/RPF5/EBIA8)
/M2-CS: A2.12 (CS), U4.76 (RD1/SCK1/RPD1)
/M2-DIR: A2.16 (DIR), U4.71 (RD0/INT0/RTCC/RPD0/AEMDIO/EMDIO)
/M2-EN: A2.9 (EN), R39.1, U4.77 (RD2/PMD14/RPD2/ETXEN/EBID14)
/M2-STP: A2.15 (STEP), U4.73 (RC14/T1CK/RPC14/SOSCO)
/M3-CS: A3.12 (CS), U4.80 (RD13/PMD13/ETXD3/EBID13)
/M3-DIR: A3.16 (DIR), U4.78 (RD3/PMD15/RPD3/ETXCLK/EBID15)
/M3-EN: A3.9 (EN), R40.1, U4.81 (RD4/RPD4/SQICS0)
/M3-STP: A3.15 (STEP), U4.79 (RD12/PMD12/RPD12/ETXD2/EBID12)
/M4-CS: A4.12 (CS), U4.87 (RG1/PMD9/RPG1/EXTERR/EBID9)
/M4-DIR: A4.16 (DIR), U4.86 (RF1/PMD10/RPF1/ETXD0/EBID10)
/M4-EN: A4.9 (EN), R41.1, U4.88 (RG0/PMD8/RPG0/EBID8)
/M4-STP: A4.15 (STEP), U4.85 (RF0/PMD11/RPF0/ETXD1/EBID11)
/M5-CS: A5.12 (CS), U4.99 (RE3/PMD3/RPE3/EBID3)
/M5-DIR: A5.16 (DIR), U4.94 (RE1/PMD1/EBID1)
/M5-EN: A5.9 (EN), R42.1, U4.100 (RE4/PMD4/AN18/EBID4)
/M5-STP: A5.15 (STEP), U4.98 (RE2/PMD2/EBID2)
/M-MISO: A1.13 (SDO), A2.13 (SDO), A3.13 (SDO), A4.13 (SDO), A5.13 (SDO), U4.67 (RA15/SDA1/RPA15/AETXEN)
/M-MOSI: A1.10 (SDI), A2.10 (SDI), A3.10 (SDI), A4.10 (SDI), A5.10 (SDI), U4.70 (RD11/RPD11/AEMDC/EMDC)
/M-SCK: A1.11 (SCK), A2.11 (SCK), A3.11 (SCK), A4.11 (SCK), A5.11 (SCK), U4.69 (RD10/SCK4/RPD10)
/MCLR: J3.1, R10.1, U4.15 (MCLR)
/MCURX-SCL3: J12.12, J16.24, J23.6, R25.2, R26.2, U4.58 (RF8/SCL3/RPF8/EBIRDY2)
/MCUTX-F3: J12.9, J16.23, J23.5, U4.56 (RF3/USBID/RPF3)
/PGEC1: J3.2, J12.3, U4.24 (RB1/AN1/RPB1/PGEC1)
/PGED1: J3.3, J12.4, U4.25 (RB0/AN0/RPB0/PGED1)
/RB15: J12.6, U4.44 (RB15/AN10/PMA0/OCFB/RPB15/AETXD2/ERXD3/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)
/RE0: R96.2, U4.91 (RE0/PMD0/EBID0)
/RF12: J12.5, U4.40 (RF12/AN31/RPF12/EBIA17/TDO)
/SCL2: J12.11, R21.2, R22.2, U4.59 (RA2/SCL2/EBICS0)
/SDA2: J12.13, R19.2, R20.2, U4.60 (RA3/SDA2/EBIRDY1)
/SDA3: J12.10, R23.2, R24.2, U4.57 (RF2/SDA3/RPF2/EBIRDY3)
/SD_CLK: J2.5 (CLK), U4.39 (RF13/AN30/SCK5/RPF13/EBIA18/TDI)
/SD_DETCRD: R13.2, R14.2
/SD_MISO: J2.7 (DAT0), U4.34 (RB10/AN5/PMA13/RPB10/CVREFOUT/EBIA13)
/SD_MOSI: J2.3 (CMD), U4.33 (RB9/AN49/PMA7/RPB9/EBIA7)
/SD_~CS~: J2.2 (DAT3/CD), R7.1, U4.38 (RA1/AN29/EBIA19/TCK)
/SOSCI: U4.72 (RC13/RPC13/SOSCI), U5.3 (OUT)
/SQICLK: U1.6 (SCK), U4.89 (RA6/SQICLK/TRCLK)
/SQICS1: R1.1, U1.1 (CE#), U4.82 (RD5/RPD5/SQICS1)
/SQID0: U1.5 (SIO0/SI), U4.97 (RG13/SQID0/TRD0)
/SQID1: U1.2 (SIO1/SO), U4.96 (RG12/SQID1/TRD1)
/SQID2: U1.3 (SIO2/WP#), U4.95 (RG14/SQID2/TRD2)
/SQID3: U1.7 (SIO3/HOLD), U4.90 (RA7/SQID3/TRD3)
/SSR-1: U4.28 (RA9/AN27/VREF-/CVREF-/AERXD2), U7.1 (1A)
/SSR-2: U4.29 (RA10/AN28/VREF+/CVREF+/AERXD3), U7.3 (2A)
/SSRD-1: D12.1, J1.1, R29.1
/SSRD-2: D14.1, J1.2, R30.1
/SW1: R66.1, U4.35 (RB11/AN6/AETXERR/ERXERR)
/SW2: R76.1, U4.21 (RB4/AN4/C1INB)
/SW3: R82.1, U4.23 (RB2/AN2/RPB2/C2INB)
/SW4: R87.1, U4.32 (RB8/AN48/PMA10/RPB8/EBIA10)
/TH1_N: C33.1, C35.1, D10.1, J1.7, R27.2, R31.2, R34.1
/TH1_P: C35.2, C37.2, D15.1, J1.6, R32.2
/TH2-N: C65.1, D19.1, J1.5, R44.2, U10.2 (BIAS)
/TH2-P: C49.1, D18.1, J1.4, R43.2
/THERM_N: C34.1, C36.1, R28.1, U3.17 (AIN2/IEXC/GPIO2)
/THERM_P: C36.2, C38.2, R33.1, U3.18 (AIN3/IEXC/GPIO3)
/THPF_N: D9.A, D11.K, R27.1, R28.2
/THPF_P: D13.A, D16.K, R32.1, R33.2
/TRM-~CS~: U4.8 (RC3/AN20/PMWR/RPC3/EBIWE), U10.9 (~CS)
/TRM-~DRDY~: U4.4 (RE6/AN16/PMD6/EBID6), U10.7 (~DRDY)
/TRM-~FAULT~: U4.5 (RE7/AN15/PMD7/EBID7), U10.13 (~FAULT)
/W-BOOT: J14.31, U4.42 (RB13/AN8/AECOL/ERXD1), U14.25 (IO0)
/W-CTS: J14.35, U14.23 (IO15)
/W-IO1: J14.13, U14.35 (TXD0/IO1)
/W-IO2: J14.33, U14.24 (IO2)
/W-IO3: J14.15, U14.34 (RXD0/IO3)
/W-IO4: J14.29, U14.26 (IO4)
/W-IO5: J14.23, U14.29 (IO5)
/W-IO18: J14.21, U14.30 (IO18)
/W-IO19: J14.19, U14.31 (IO19)
/W-IO21: J14.17, U14.33 (IO21)
/W-IO22: J14.11, U14.36 (IO22)
/W-IO23: J14.9, U14.37 (IO23)
/W-IO25: J14.26, U14.10 (IO25)
/W-IO26: J14.28, U14.11 (IO26)
/W-IO27: J14.30, U14.12 (IO27)
/W-IO32: J14.22, U14.8 (IO32)
/W-IO33: J14.24, U14.9 (IO33)
/W-IO34: J14.18, U14.6 (IO34)
/W-IO35: J14.20, U14.7 (IO35)
/W-RTS: J14.32, U14.13 (IO14)
/W-RX: J14.27, R60.1, U4.48 (RD15/AN33/SCK6/RPD15/AETXD1), U14.27 (IO16)
/W-RX0: J14.36, U14.16 (IO13)
/W-SVN: J14.16, U14.5 (SENSOR_VN)
/W-SVP: J14.14, U14.4 (SENSOR_VP)
/W-TX: J14.25, R59.1, U4.47 (RD14/AN32/RPD14/AETXD0), U14.28 (IO17)
/W-TX0: J14.34, U14.14 (IO12)
/W_EN: J14.12, R58.1, U4.41 (RB12/AN7/PMA11/AECRS/ERXD0/EBIA11), U14.3 (EN)
GND: A1.1 (GND), A1.7 (GND), A2.1 (GND), A2.7 (GND), A3.1 (GND), A3.7 (GND), A4.1 (GND), A4.7 (GND), A5.1 (GND), A5.7 (GND), C1.2, C2.2, C3.2, C4.2, C5.2, C6.2, C7.2, C8.2, C9.2, C10.2, C12.1, C14.2, C15.2, C16.2, C17.2, C19.2, C20.1, C21.2, C22.2, C23.2, C24.2, C25.2, C26.2, C27.2, C28.2, C29.2, C30.2, C31.2, C32.2, C33.2, C34.2, C37.1, C38.1, C39.2, C40.2, C41.2, C42.2, C43.2, C44.2, C45.2, C46.2, C47.2, C48.2, C49.2, C50.2, C51.2, C52.2, C53.2, C54.2, C55.2, C56.2, C58.1, C59.2, C60.2, C61.2, C62.2, C63.2, C64.2, C65.2, C66.2, C67.2, C68.2, C69.2, C70.2, C71.2, C72.2, C73.2, C74.2, C75.2, C77.2, C78.2, C79.2, C80.2, C82.2, C83.2, C84.2, C85.2, C86.2, C87.2, C88.2, C89.2, D1.2, D2.2, D3.2, D5.2, D6.A, D8.A, D10.2, D11.A, D12.2, D14.2, D15.2, D16.A, D17.2, D18.2, D19.2, D20.2, D21.3 (K), D22.2, D23.1, D24.1, D25.1, D26.1, D27.1, J1.3, J1.8, J2.6 (VSS), J2.9 (DET_B), J2.11 (SHIELD), J3.5, J6.2, J9.3, J9.4, J12.7, J12.8, J12.19, J12.20, J13.4, J13.6, J14.5, J14.6, J14.7, J14.8, J14.10, J16.1, J16.21, J16.25, J16.30, J16.31, J17.A1, J17.A12, J17.B1, J17.B12, J17.SH, J18.2, J18.4, J18.6, J23.1, J23.2, J23.7, Q13.2 (S), R1.2, R3.2, R4.2, R6.2, R7.2, R18.2, R34.2, R38.2, R39.2, R40.2, R41.2, R42.2, R46.2, R47.2, R49.2, R55.2, R58.2, R59.2, R60.2, R69.2, R70.2, R72.2, R73.2, R89.2, RLY1.2 (K), RLY2.2 (K), S1.1, S2.1, S3.1, S4.1, U1.4 (VSS), U2.4 (GND), U3.2 (DGND), U3.3 (CLK), U3.21 (AVSS), U4.13 (VSS), U4.31 (AVSS), U4.36 (VSS), U4.45 (VSS), U4.53 (VSS), U4.63 (VSS), U4.75 (VSS), U4.84 (VSS), U4.92 (VSS), U5.2 (GND), U6.2 (GND), U7.4 (GND), U7.6 (3A), U8.2 (GND), U8.4 (ADD0), U9.2 (GND), U10.1 (AGND), U10.14 (DGND), U11.2 (GND), U12.2 (GND), U13.8 (GND), U14.1 (GND), U14.15 (GND), U14.38 (GND), U15.8 (GND)
unnamed: A1.3 (M1B), J5.1
unnamed: A1.4 (M1A), J5.2
unnamed: A1.5 (M2A), J5.3
unnamed: A1.6 (M2B), J5.4
unnamed: A2.3 (M1B), J7.1
unnamed: A2.4 (M1A), J7.2
unnamed: A2.5 (M2A), J7.3
unnamed: A2.6 (M2B), J7.4
unnamed: A3.3 (M1B), J8.1
unnamed: A3.4 (M1A), J8.2
unnamed: A3.5 (M2A), J8.3
unnamed: A3.6 (M2B), J8.4
unnamed: A4.3 (M1B), J10.1
unnamed: A4.4 (M1A), J10.2
unnamed: A4.5 (M2A), J10.3
unnamed: A4.6 (M2B), J10.4
unnamed: A5.3 (M1B), J11.1
unnamed: A5.4 (M1A), J11.2
unnamed: A5.5 (M2A), J11.3
unnamed: A5.6 (M2B), J11.4
unnamed: C8.1, D1.1, J1.16, R2.2, R3.1
unnamed: C7.1, C11.1, R2.1, U3.5 (REFP0/GPIO0)
unnamed: C11.2, C12.2, R4.1, U3.6 (REFN0/GPIO0)
unnamed: C13.1, U3.9 (VREFOUT)
unnamed: C13.2, U3.10 (VREFCOM)
unnamed: C15.1, D2.1, J1.15, R8.2, RLY1.4 (DRAIN)
unnamed: C17.1, C18.1, R8.1, U3.11 (AIN0/IEXC)
unnamed: C18.2, C20.2, R12.1, U3.12 (AIN1/IEXC)
unnamed: C21.1, R9.2, R10.2
unnamed: C23.1, D3.1, J1.14, R12.2, RLY2.4 (DRAIN)
unnamed: C25.1, D4.K, D5.1, J1.13, RLY2.3 (DRAIN)
unnamed: C31.1, R17.2, R18.1, U4.51 (VBUS)
unnamed: C43.1, JP1.2 (C), U10.5 (AVDD)
unnamed: C48.1, C57.1, R43.1, U10.4 (T+)
unnamed: C57.2, C58.2, R44.1, U10.3 (T-)
unnamed: C77.1, D20.1, Q6.5 (D), Q6.6 (D), Q6.7 (D), Q6.8 (D), R50.1
unnamed: C82.1, D22.1, Q7.5 (D), Q7.6 (D), Q7.7 (D), Q7.8 (D), R56.1
unnamed: D4.A, Q1.3 (C), R15.1
unnamed: D6.K, Q1.1 (B), R15.2
unnamed: D7.A, Q2.3 (C), R16.1
unnamed: D8.K, Q2.1 (B), R16.2
unnamed: D21.1 (A), R52.2, R53.2
unnamed: D21.2 (A), R61.2, R65.2
unnamed: D23.2, R64.2
unnamed: D24.2, R68.2
unnamed: D25.2, R77.2
unnamed: D26.2, R79.2
unnamed: D27.2, R83.2
unnamed: D28.A, D29.1, Q13.3 (D), RLY3.2 (C2)
unnamed: D29.2, R97.2
unnamed: J2.10 (DET_A), R14.1
unnamed: J13.1, J16.2
unnamed: J13.3, J16.3
unnamed: J13.5, J16.4
unnamed: J13.7, J16.5
unnamed: J13.8, J16.15
unnamed: J13.9, J16.6
unnamed: J13.10, J16.14
unnamed: J13.11, J16.7
unnamed: J13.12, J16.13
unnamed: J13.13, J16.8
unnamed: J13.14, J16.17
unnamed: J13.15, J16.9
unnamed: J13.16, J16.16
unnamed: J13.17, J16.10
unnamed: J13.18, J16.18
unnamed: J13.19, J16.11
unnamed: J13.20, J16.19
unnamed: J13.21, J16.12
unnamed: J13.22, J16.20
unnamed: J15.1, RLY3.4 (B)
unnamed: J15.2, RLY3.3 (A)
unnamed: J20.1, U14.21 (SDO/SD0)
unnamed: J20.2, U14.22 (SDI/SD1)
unnamed: J20.3, U14.17 (SHD/SD2)
unnamed: J20.4, U14.18 (SWP/SD3)
unnamed: J20.5, U14.20 (SCK/CLK)
unnamed: J20.6, U14.19 (SCS/CMD)
unnamed: Q1.2 (E), U3.20 (IEXC1)
unnamed: Q2.2 (E), U3.19 (IEXC2)
unnamed: Q3.1 (G), Q4.1 (G), R45.1, R46.1
unnamed: Q3.3 (D), Q4.3 (D)
unnamed: Q5.1 (G), R47.1
unnamed: Q6.1 (S), Q6.2 (S), Q6.3 (S), R57.2, R61.1
unnamed: Q6.4 (G), R48.2, R49.1
unnamed: Q7.1 (S), Q7.2 (S), Q7.3 (S), R51.2, R52.1
unnamed: Q7.4 (G), R54.2, R55.1
unnamed: Q8.1 (B), R63.1
unnamed: Q9.1 (B), R75.1
unnamed: Q10.1 (B), R81.1
unnamed: Q11.1 (B), R67.1
unnamed: Q12.1 (B), R78.1
unnamed: Q13.1 (G), R96.1
unnamed: R5.1, RLY1.1 (A)
unnamed: R11.1, RLY2.1 (A)
unnamed: R29.2, U7.7 (1Y)
unnamed: R30.2, U7.5 (2Y)
unnamed: R62.2, R66.2, S1.2
unnamed: R63.2, U13.3 (QD)
unnamed: R67.2, U13.4 (QE)
unnamed: R70.1, U13.13 (~OE)
unnamed: R71.2, U13.10 (~SRCLR)
unnamed: R74.2, R76.2, S2.2
unnamed: R75.2, U13.5 (QF)
unnamed: R78.2, U13.6 (QG)
unnamed: R80.2, R82.2, S3.2
unnamed: R81.2, U13.7 (QH)
unnamed: R84.2, U15.15 (QA)
unnamed: R85.2, U15.1 (QB)
unnamed: R86.2, R87.2, S4.2
unnamed: R88.2, U15.2 (QC)
unnamed: R89.1, U15.13 (~OE)
unnamed: R90.2, U15.10 (~SRCLR)
unnamed: R91.2, U15.3 (QD)
unnamed: R92.2, U15.4 (QE)
unnamed: R93.2, U15.5 (QF)
unnamed: R94.2, U15.6 (QG)
unnamed: R95.2, U15.7 (QH)
unnamed: U2.1 (1A), U4.16 (RG9/AN11/PMA2/RPG9/AEREFCLK/AERXCLK/ERE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)
unnamed: U2.3 (2A), U4.18 (RE8/AN25/RPE8/AERXD0)
unnamed: U2.6 (3A), U4.17 (RA0/AN24/EBIA16/TMS)
unnamed: U13.9 (QH'), U15.14 (SER)
VBUS: C47.1, D17.5, J17.A4, J17.A9, J17.B4, J17.B9, Q3.2 (S), R17.1
VDD: C50.1, J6.1, Q5.3 (D), R45.2, U11.3 (OUT)

Notes on the sheet:
Cold junction compensation Place close to thermocouple conector
Order extendended temperature version
place connector close to caps
don't forget to add heatsink
12VDC input
Place close to miccrocontroller, avoid vias and try to match wire lenght.
Place close to connector for junction temperature compensation
Place both connectors close to each other
GET A HIGH PRECISION LOW DRIFT RESISTOR
Se modificó paquete de libreria de Digikey en base a formato sugerido en hoja de datos
change to 24MHz version
