fcc89/ovctrl/pcb/ovc.kicad_pcb

## KiCad design pcb/ovc.kicad_pcb (continued)

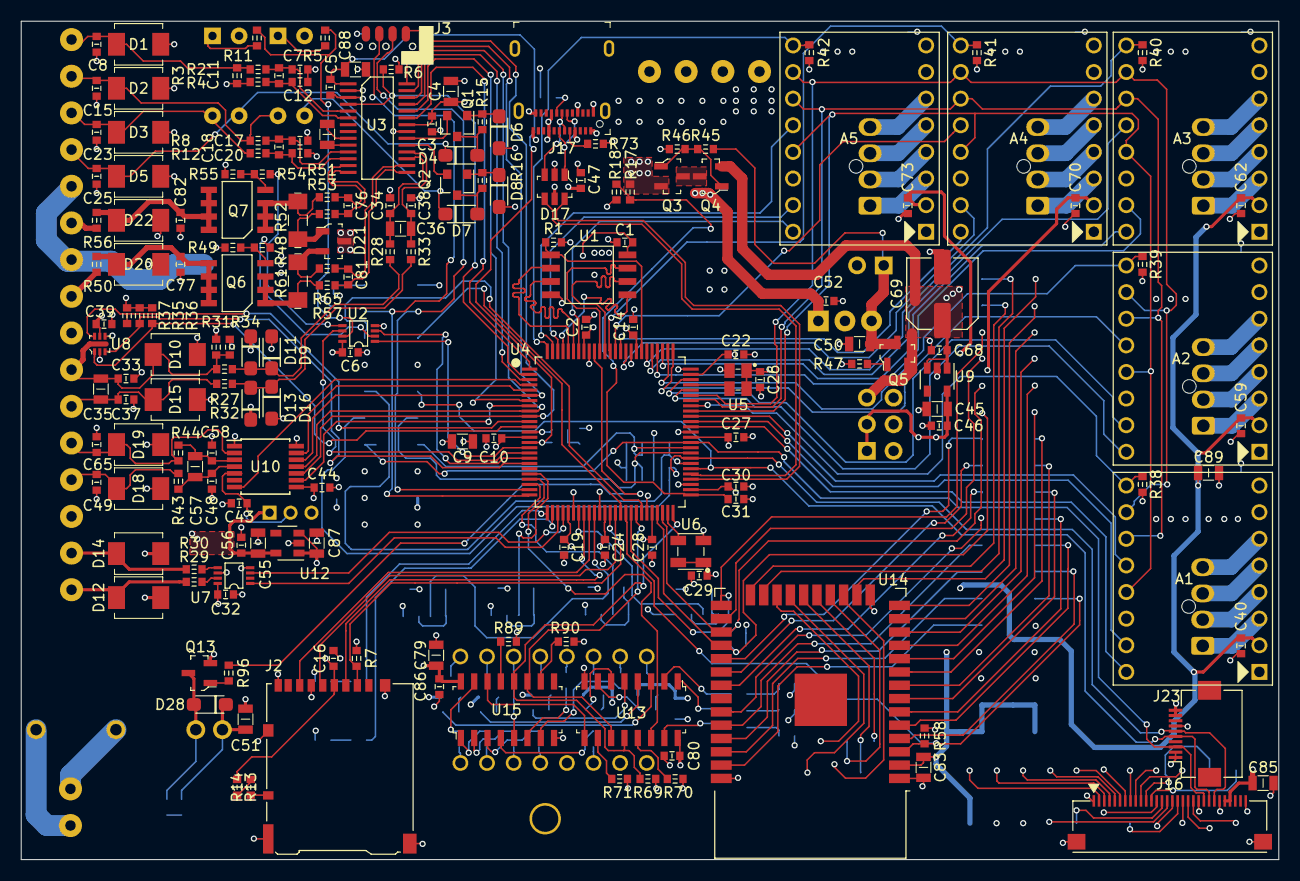
[picture p24: board ovc.kicad_pcb from above]

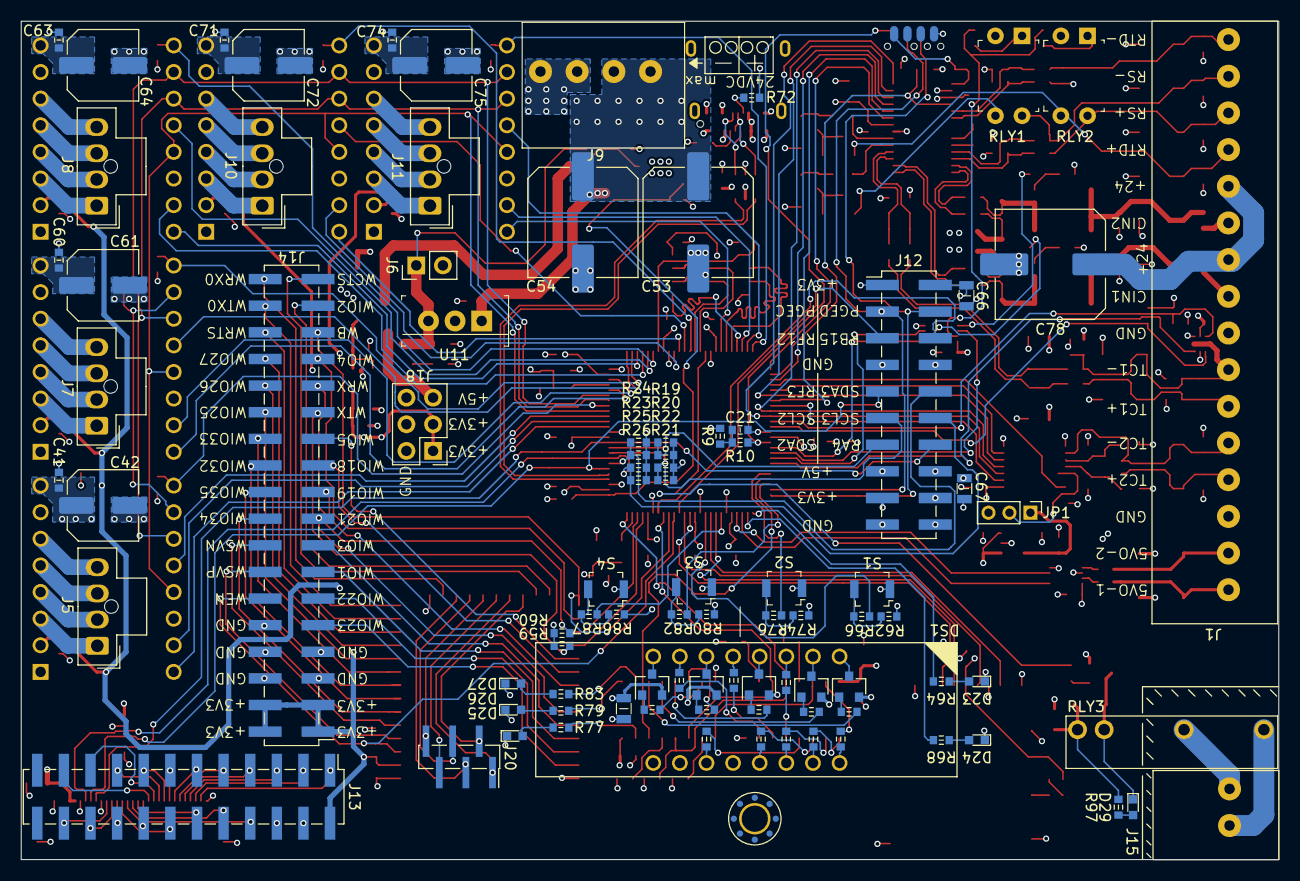
[picture p25: board ovc.kicad_pcb from below]

Board: 4 copper layers, 120.0 x 80.0 mm, 276 parts (92 on the bottom side), 271 nets.
