fcc89/ovctrl/firmware/RTOS-test/firmware/src/config/rtos/initialization.c

/*******************************************************************************
  System Initialization File

  File Name:
    initialization.c

  Summary:
    This file contains source code necessary to initialize the system.

  Description:
    This file contains source code necessary to initialize the system.  It
    implements the "SYS_Initialize" function, defines the configuration bits,
    and allocates any necessary global system resources,
 *******************************************************************************/

// DOM-IGNORE-BEGIN
/*******************************************************************************
* Copyright (C) 2018 Microchip Technology Inc. and its subsidiaries.
*
* Subject to your compliance with these terms, you may use Microchip software
* and any derivatives exclusively with Microchip products. It is your
* responsibility to comply with third party license terms applicable to your
* use of third party software (including open source software) that may
* accompany Microchip software.
*
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
* IN NO EVENT WILL MICROCHIP BE LIABLE FOR ANY INDIRECT, SPECIAL, PUNITIVE,
* INCIDENTAL OR CONSEQUENTIAL LOSS, DAMAGE, COST OR EXPENSE OF ANY KIND
* WHATSOEVER RELATED TO THE SOFTWARE, HOWEVER CAUSED, EVEN IF MICROCHIP HAS
* BEEN ADVISED OF THE POSSIBILITY OR THE DAMAGES ARE FORESEEABLE. TO THE
* FULLEST EXTENT ALLOWED BY LAW, MICROCHIP'S TOTAL LIABILITY ON ALL CLAIMS IN
* ANY WAY RELATED TO THIS SOFTWARE WILL NOT EXCEED THE AMOUNT OF FEES, IF ANY,
* THAT YOU HAVE PAID DIRECTLY TO MICROCHIP FOR THIS SOFTWARE.
 *******************************************************************************/
// DOM-IGNORE-END

// *****************************************************************************
// *****************************************************************************
// Section: Included Files
// *****************************************************************************
// *****************************************************************************
#include "configuration.h"
#include "definitions.h"
#include "device.h"



// ****************************************************************************
// ****************************************************************************
// Section: Configuration Bits
// ****************************************************************************
// ****************************************************************************

/*** DEVCFG0 ***/
#pragma config DEBUG =      OFF
#pragma config JTAGEN =     OFF
#pragma config ICESEL =     ICS_PGx1
#pragma config TRCEN =      OFF
#pragma config BOOTISA =    MIPS32
#pragma config FECCCON =    OFF_UNLOCKED
#pragma config FSLEEP =     OFF
#pragma config DBGPER =     PG_ALL
#pragma config SMCLR =      MCLR_NORM
#pragma config SOSCGAIN =   GAIN_LEVEL_3
#pragma config SOSCBOOST =  ON
#pragma config POSCGAIN =   GAIN_LEVEL_3
#pragma config POSCBOOST =  ON
#pragma config EJTAGBEN =   NORMAL
#pragma config CP =         OFF

/*** DEVCFG1 ***/
#pragma config FNOSC =      SPLL
#pragma config DMTINTV =    WIN_127_128
#pragma config FSOSCEN =    ON
#pragma config IESO =       OFF
#pragma config POSCMOD =    EC
#pragma config OSCIOFNC =   OFF
#pragma config FCKSM =      CSECME
#pragma config WDTPS =      PS1048576
#pragma config WDTSPGM =    STOP
#pragma config FWDTEN =     OFF
#pragma config WINDIS =     NORMAL
#pragma config FWDTWINSZ =  WINSZ_25
#pragma config DMTCNT =     DMT31
#pragma config FDMTEN =     OFF

/*** DEVCFG2 ***/
#pragma config FPLLIDIV =   DIV_1
#pragma config FPLLRNG =    RANGE_8_16_MHZ
#pragma config FPLLICLK =   PLL_POSC
#pragma config FPLLMULT =   MUL_33
#pragma config FPLLODIV =   DIV_2
#pragma config UPLLFSEL =   FREQ_12MHZ

/*** DEVCFG3 ***/
#pragma config USERID =     0xffff
#pragma config FMIIEN =     ON
#pragma config FETHIO =     ON
#pragma config PGL1WAY =    ON
#pragma config PMDL1WAY =   ON
#pragma config IOL1WAY =    ON
#pragma config FUSBIDIO =   ON

/*** BF1SEQ0 ***/

#pragma config TSEQ =       0xffff
#pragma config CSEQ =       0x0





// *****************************************************************************
// *****************************************************************************
// Section: Driver Initialization Data
// *****************************************************************************
// *****************************************************************************
// <editor-fold defaultstate="collapsed" desc="DRV_I2C Instance 0 Initialization Data">

/* I2C Client Objects Pool */
static DRV_I2C_CLIENT_OBJ drvI2C0ClientObjPool[DRV_I2C_CLIENTS_NUMBER_IDX0];

/* I2C PLib Interface Initialization */
const DRV_I2C_PLIB_INTERFACE drvI2C0PLibAPI = {

    /* I2C PLib Transfer Read Add function */
    .read = (DRV_I2C_PLIB_READ)I2C4_Read,

    /* I2C PLib Transfer Write Add function */
    .write = (DRV_I2C_PLIB_WRITE)I2C4_Write,


    /* I2C PLib Transfer Write Read Add function */
    .writeRead = (DRV_I2C_PLIB_WRITE_READ)I2C4_WriteRead,

    /* I2C PLib Transfer Status function */
    .errorGet = (DRV_I2C_PLIB_ERROR_GET)I2C4_ErrorGet,

    /* I2C PLib Transfer Setup function */
    .transferSetup = (DRV_I2C_PLIB_TRANSFER_SETUP)I2C4_TransferSetup,

    /* I2C PLib Callback Register */
    .callbackRegister = (DRV_I2C_PLIB_CALLBACK_REGISTER)I2C4_CallbackRegister,
};


/* I2C Driver Initialization Data */
const DRV_I2C_INIT drvI2C0InitData =
{
    /* I2C PLib API */
    .i2cPlib = &drvI2C0PLibAPI,

    /* I2C Number of clients */
    .numClients = DRV_I2C_CLIENTS_NUMBER_IDX0,

    /* I2C Client Objects Pool */
    .clientObjPool = (uintptr_t)&drvI2C0ClientObjPool[0],

    /* I2C Clock Speed */
    .clockSpeed = DRV_I2C_CLOCK_SPEED_IDX0,
};

// </editor-fold>

// <editor-fold defaultstate="collapsed" desc="DRV_SPI Instance 0 Initialization Data">

/* SPI Client Objects Pool */
static DRV_SPI_CLIENT_OBJ drvSPI0ClientObjPool[DRV_SPI_CLIENTS_NUMBER_IDX0];

/* SPI PLIB Interface Initialization */
const DRV_SPI_PLIB_INTERFACE drvSPI0PlibAPI = {

    /* SPI PLIB Setup */
    .setup = (DRV_SPI_PLIB_SETUP)SPI2_TransferSetup,

    /* SPI PLIB WriteRead function */
    .writeRead = (DRV_SPI_PLIB_WRITE_READ)SPI2_WriteRead,

    /* SPI PLIB Transfer Status function */
    .isBusy = (DRV_SPI_PLIB_IS_BUSY)SPI2_IsBusy,

    /* SPI PLIB Callback Register */
    .callbackRegister = (DRV_SPI_PLIB_CALLBACK_REGISTER)SPI2_CallbackRegister,
};

const uint32_t drvSPI0remapDataBits[]= { 0x00000000, 0xFFFFFFFF, 0xFFFFFFFF, 0xFFFFFFFF, 0xFFFFFFFF, 0xFFFFFFFF, 0xFFFFFFFF, 0xFFFFFFFF, 0x00000400 };
const uint32_t drvSPI0remapClockPolarity[] = { 0x00000000, 0x00000040 };
const uint32_t drvSPI0remapClockPhase[] = { 0x00000000, 0x00000100 };

/* SPI Driver Initialization Data */
const DRV_SPI_INIT drvSPI0InitData =
{
    /* SPI PLIB API */
    .spiPlib = &drvSPI0PlibAPI,

    .remapDataBits = drvSPI0remapDataBits,

    .remapClockPolarity = drvSPI0remapClockPolarity,

    .remapClockPhase = drvSPI0remapClockPhase,

    /* SPI Number of clients */
    .numClients = DRV_SPI_CLIENTS_NUMBER_IDX0,

    /* SPI Client Objects Pool */
    .clientObjPool = (uintptr_t)&drvSPI0ClientObjPool[0],

    /* DMA Channel for Transmit */
    .dmaChannelTransmit = SYS_DMA_CHANNEL_NONE,

    /* DMA Channel for Receive */
    .dmaChannelReceive  = SYS_DMA_CHANNEL_NONE,

};

// </editor-fold>
// <editor-fold defaultstate="collapsed" desc="DRV_USART Instance 0 Initialization Data">

static DRV_USART_CLIENT_OBJ drvUSART0ClientObjPool[DRV_USART_CLIENTS_NUMBER_IDX0];


const DRV_USART_PLIB_INTERFACE drvUsart0PlibAPI = {
    .readCallbackRegister = (DRV_USART_PLIB_READ_CALLBACK_REG)UART1_ReadCallbackRegister,
    .read = (DRV_USART_PLIB_READ)UART1_Read,
    .readIsBusy = (DRV_USART_PLIB_READ_IS_BUSY)UART1_ReadIsBusy,
    .readCountGet = (DRV_USART_PLIB_READ_COUNT_GET)UART1_ReadCountGet,
    .writeCallbackRegister = (DRV_USART_PLIB_WRITE_CALLBACK_REG)UART1_WriteCallbackRegister,
    .write = (DRV_USART_PLIB_WRITE)UART1_Write,
    .writeIsBusy = (DRV_USART_PLIB_WRITE_IS_BUSY)UART1_WriteIsBusy,
    .writeCountGet = (DRV_USART_PLIB_WRITE_COUNT_GET)UART1_WriteCountGet,
    .errorGet = (DRV_USART_PLIB_ERROR_GET)UART1_ErrorGet,
    .serialSetup = (DRV_USART_PLIB_SERIAL_SETUP)UART1_SerialSetup
};

const uint32_t drvUsart0remapDataWidth[] = { 0xFFFFFFFF, 0xFFFFFFFF, 0xFFFFFFFF, 0x0, 0x6 };
const uint32_t drvUsart0remapParity[] = { 0x0, 0x2, 0x4, 0xFFFFFFFF, 0xFFFFFFFF, 0xFFFFFFFF };
const uint32_t drvUsart0remapStopBits[] = { 0x0, 0xFFFFFFFF, 0x1 };
const uint32_t drvUsart0remapError[] = { 0x2, 0x8, 0x4 };

const DRV_USART_INIT drvUsart0InitData =
{
    .usartPlib = &drvUsart0PlibAPI,

    /* USART Number of clients */
    .numClients = DRV_USART_CLIENTS_NUMBER_IDX0,

    /* USART Client Objects Pool */
    .clientObjPool = (uintptr_t)&drvUSART0ClientObjPool[0],

    .dmaChannelTransmit = SYS_DMA_CHANNEL_NONE,

    .dmaChannelReceive = SYS_DMA_CHANNEL_NONE,


    .remapDataWidth = drvUsart0remapDataWidth,

    .remapParity = drvUsart0remapParity,

    .remapStopBits = drvUsart0remapStopBits,

    .remapError = drvUsart0remapError,
};

// </editor-fold>


// *****************************************************************************
// *****************************************************************************
// Section: System Data
// *****************************************************************************
// *****************************************************************************
/* Structure to hold the object handles for the modules in the system. */
SYSTEM_OBJECTS sysObj;

// *****************************************************************************
// *****************************************************************************
// Section: Library/Stack Initialization Data
// *****************************************************************************
// *****************************************************************************


// *****************************************************************************
// *****************************************************************************
// Section: System Initialization
// *****************************************************************************
// *****************************************************************************



/*******************************************************************************
  Function:
    void SYS_Initialize ( void *data )

  Summary:
    Initializes the board, services, drivers, application and other modules.

  Remarks:
 */

void SYS_Initialize ( void* data )
{
    /* Start out with interrupts disabled before configuring any modules */
    __builtin_disable_interrupts();

  
    CLK_Initialize();
	GPIO_Initialize();
    /* Configure Prefetch, Wait States and ECC */
    PRECONbits.PREFEN = 3;
    PRECONbits.PFMWS = 2;
    CFGCONbits.ECCCON = 3;


    OCMP5_Initialize();

	UART1_Initialize();

    I2C4_Initialize();

    TMR2_Initialize();


	SPI2_Initialize();

    RTCC_Initialize();

    /* Initialize I2C0 Driver Instance */
    sysObj.drvI2C0 = DRV_I2C_Initialize(DRV_I2C_INDEX_0, (SYS_MODULE_INIT *)&drvI2C0InitData);
    /* Initialize SPI0 Driver Instance */
    sysObj.drvSPI0 = DRV_SPI_Initialize(DRV_SPI_INDEX_0, (SYS_MODULE_INIT *)&drvSPI0InitData);
    sysObj.drvUsart0 = DRV_USART_Initialize(DRV_USART_INDEX_0, (SYS_MODULE_INIT *)&drvUsart0InitData);




    APP_Initialize();


    EVIC_Initialize();

	/* Enable global interrupts */
    __builtin_enable_interrupts();


}


/*******************************************************************************
 End of File
*/
