fcc89/ovctrl/(commit log)

2019-09-27 base uppload
    [ovc.kicad_pcb, ovc.sch]
2019-09-29 added connections to ucontroller
    [ovc.sch]
2019-09-30 added memory pull ups connectors and memory ic
    [ovc.sch]
2019-10-04 finished schematic and starting location of components, advance in analog front end
    [ovc.sch]
2019-10-11 finished schematic, layed out components in pcb and advanced in routing
    [ovc.kicad_pcb, ovc.sch]
2019-10-29 gerber generated and fabricated
    [ovc-B_Cu.gbr, ovc-B_Mask.gbr, ovc-B_SilkS.gbr, ovc-Edge_Cuts.gbr, ovc-F_Cu.gbr, ovc-F_Mask.gbr, ovc-F_SilkS.gbr, ovc-In1_Cu.gbr]
2019-11-24 Started module testing firmware
    [configuration.h, ovc.kicad_pcb, ovc.sch]
2019-11-24 Added PDF schematic and pcb
    [ovc.kicad_pcb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]
2020-01-03 advances in firmware
    [ovc.sch]
